Cameron-Ray/IrrigationPiHat/Combined Schematic & PCB/Main Circuit.html

# C:\Users\cdude\University of Cape Town\EEE3088F - General\FinalCircuitSchematic&PCB\Main Circuit.sch

08/06/2021 5:21:09 PM

Eeschema (5.1.10)-1

Component Count:86

Ref | Qnty | Value | Part | Datasheet | Description
C1 | 1 | 0.01µ | Device:C_Small | ~ | Unpolarized capacitor, small symbol
C2 | 1 | 1n | Device:C_Small | ~ | Unpolarized capacitor, small symbol
C3 | 1 | Cpar=100p,Rser=10k | Device:C_Small | ~ | Unpolarized capacitor, small symbol
C4 | 1 | 4.7µ | Device:C_Small | ~ | Unpolarized capacitor, small symbol
C5, C6 | 2 | 0.1µ | Device:C_Small | ~ | Unpolarized capacitor, small symbol
C7 | 1 | 150µ x3, Rser=0.1 | Device:C_Small | ~ | Unpolarized capacitor, small symbol
D1, D4 | 2 | Red LED | Device:LED | ~ | Light emitting diode
D2, D5 | 2 | Orange LED | Device:LED | ~ | Light emitting diode
D3, D6 | 2 | Green LED | Device:LED | ~ | Light emitting diode
IC1 | 1 | LTC3895IFE#TRPBF | LTC3895PartLib:LTC3895IFE#TRPBF | https://www.analog.com/media/en/technical-documentation/data-sheets/3895fa.pdf
J1, J2, J3, J5, J6, J7, J8 | 7 | Conn_01x02_Male | Connector:Conn_01x02_Male | ~ | Generic connector, single row, 01x02, script generated (kicad-library-utils/schlib/autogen/connector/)
J4 | 1 | Raspberry_Pi_2_3 | Connector:Raspberry_Pi_2_3 | https://www.raspberrypi.org/documentation/hardware/raspberrypi/schematics/rpi_SCH_3bplus_1p0_reduced.pdf | expansion header for Raspberry Pi 2 & 3
L1 | 1 | 33µ, Rser=15m | Device:L_Small | ~ | Inductor, small symbol
Q1, Q2, Q3, Q4 | 4 | PN2222A | Transistor_BJT:PN2222A | http://www.fairchildsemi.com/ds/PN/PN2222A.pdf | 1A Ic, 40V Vce, NPN Transistor, General Purpose Transistor, TO-92
Q5 | 1 | Si4482DY | Transistor_FET:BSC082N10LSG | http://www.infineon.com/dgdl/Infineon-BSC082N10LS-DS-v01_07-en.pdf?fileId=db3a3043163797a6011647faad240719 | 100A Id, 100V Vds, OptiMOS N-Channel Power MOSFET, 8.2mOhm Ron, Qg (typ) 78.0nC, PG-TDSON-8
Q6, Q7 | 2 | BSC082N10LSG | Transistor_FET:BSC082N10LSG | http://www.infineon.com/dgdl/Infineon-BSC082N10LS-DS-v01_07-en.pdf?fileId=db3a3043163797a6011647faad240719 | 100A Id, 100V Vds, OptiMOS N-Channel Power MOSFET, 8.2mOhm Ron, Qg (typ) 78.0nC, PG-TDSON-8
R1, R13 | 2 | 10K | Device:R_Small_US | ~ | Resistor, small US symbol
R2, R4, R6, R7, R11, R12, R14, R15, R17, R19, R20, R29, R30, R31 | 14 | 1K | Device:R_Small_US | ~ | Resistor, small US symbol
R3, R16 | 2 | 3636 | Device:R_Small_US | ~ | Resistor, small US symbol
R5, R18 | 2 | 2.5K | Device:R_Small_US | ~ | Resistor, small US symbol
R8, R9, R10, R21, R22, R23 | 6 | 160 | Device:R_Small_US | ~ | Resistor, small US symbol
R24 | 1 | 75k | Device:R_Small_US | ~ | Resistor, small US symbol
R25 | 1 | 1Meg | Device:R_Small_US | ~ | Resistor, small US symbol
R26 | 1 | 18.7k | Device:R_Small_US | ~ | Resistor, small US symbol
R27 | 1 | 30.1k | Device:R_Small_US | ~ | Resistor, small US symbol
R28, R33 | 2 | 511k | Device:R_Small_US | ~ | Resistor, small US symbol
R32 | 1 | 36.5k | Device:R_Small_US | ~ | Resistor, small US symbol
R34 | 1 | 6m | Device:R_Small_US | ~ | Resistor, small US symbol
R35, R36 | 2 | 1k | Device:R_Small_US | ~ | Resistor, small US symbol
RV1, RV2, RV3, RV4, RV5, RV6, RV7, RV8, RV9, RV10 | 10 | R_POT | Device:R_POT | ~ | Potentiometer
U1, U2, U3, U4, U6 | 5 | LMV324 | Amplifier_Operational:LMV324 | http://www.ti.com/lit/ds/symlink/lmv324.pdf | Quad Low-Voltage Rail-to-Rail Output Operational Amplifier, SOIC-14/SSOP-14
U5, U7 | 2 | 74HC86 | 74xx:74HC86 | http://www.ti.com/lit/gpn/sn74HC86 | Quad 2-input XOR
U8, U9 | 2 | Switch | Analog_Switch:DG308AxY | http://pdf.datasheetcatalog.com/datasheets/70/494502_DS.pdf | Quad SPST Analog Switches, normally OFF, 60Ohm Ron, SOIC-16
U10 | 1 | LMV321 | Amplifier_Operational:LMV321 | http://www.ti.com/lit/ds/symlink/lmv324.pdf | Low-Voltage Rail-to-Rail Output Operational Amplifiers, SOT-23-5/SC-70-5
