Cameron-Ray/IrrigationPiHat/Combined Schematic & PCB/PCBScreenshots/2D_Back.jpg

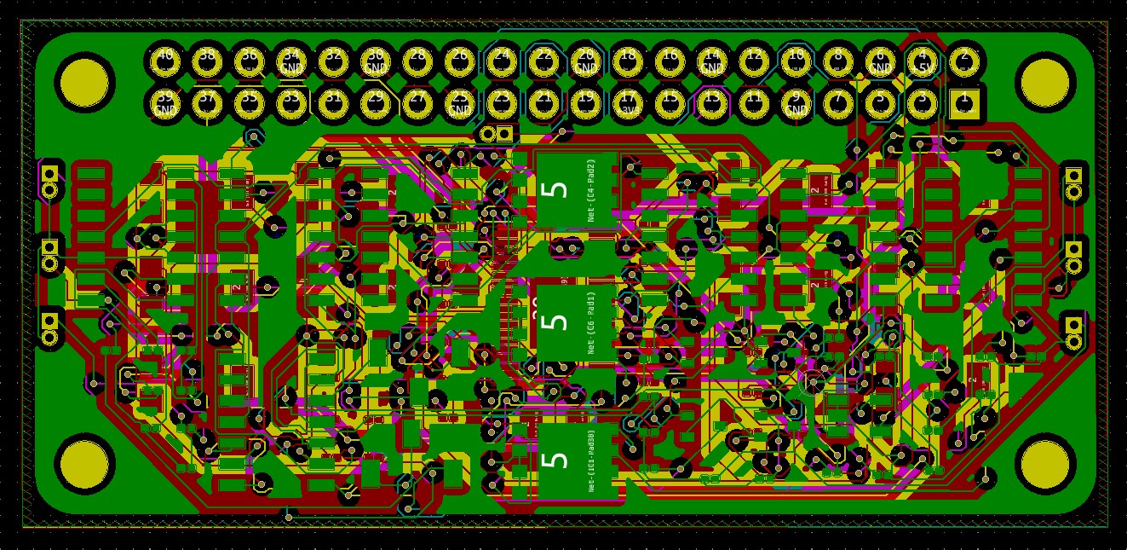
Combined Schematic & PCB/PCBScreenshots/2D_Back.jpg
