Cameron-Ray/IrrigationPiHat/Combined Schematic & PCB/PCBScreenshots/2D_Front.jpg

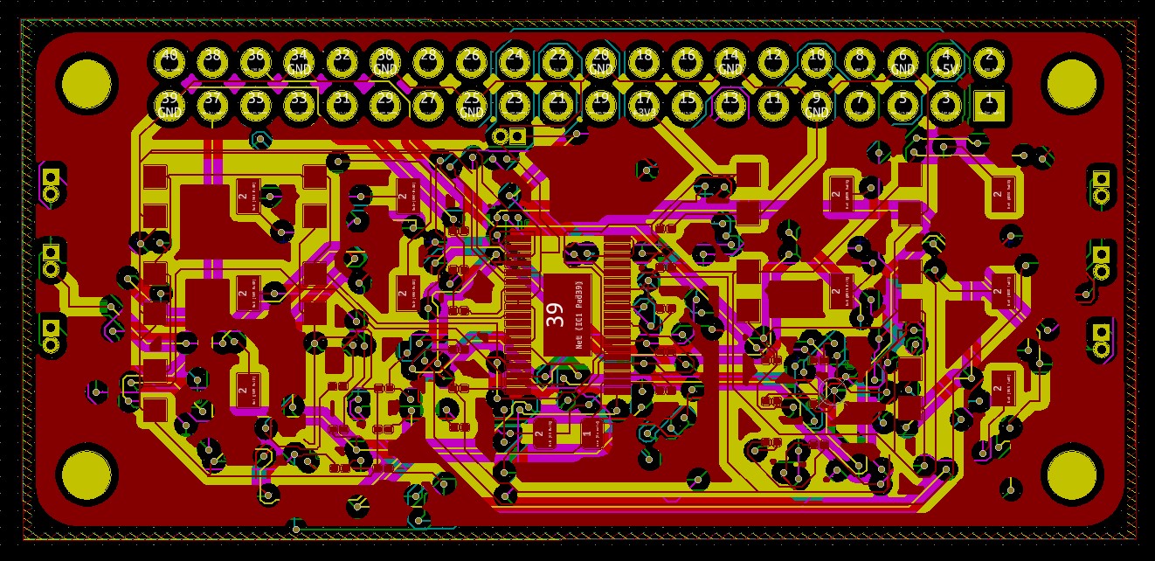
Combined Schematic & PCB/PCBScreenshots/2D_Front.jpg
