Cameron-Ray/IrrigationPiHat/Simulation Files/SimulationPlots/AmpMod_LowerBoundOutput.png

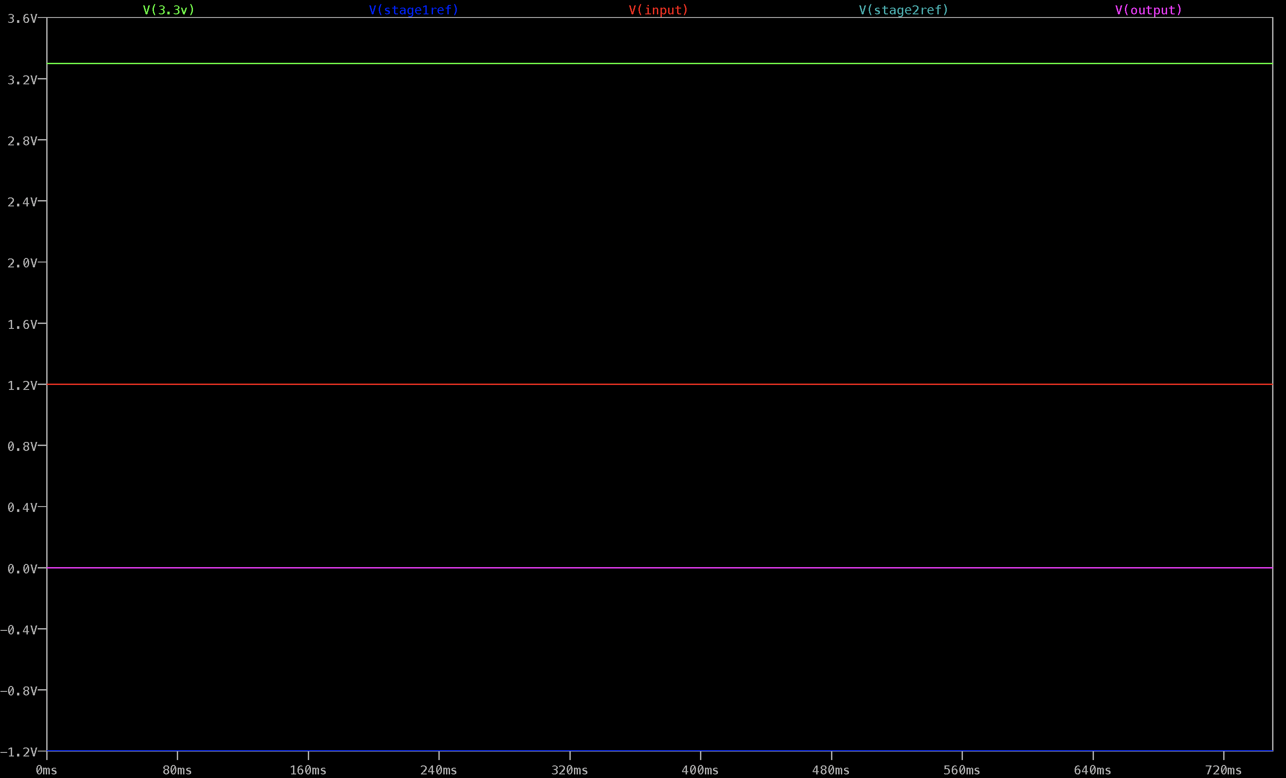
Simulation Files/SimulationPlots/AmpMod_LowerBoundOutput.png
