Cameron-Ray/IrrigationPiHat/Simulation Files/SimulationPlots/AmpMod_SineOutput.png

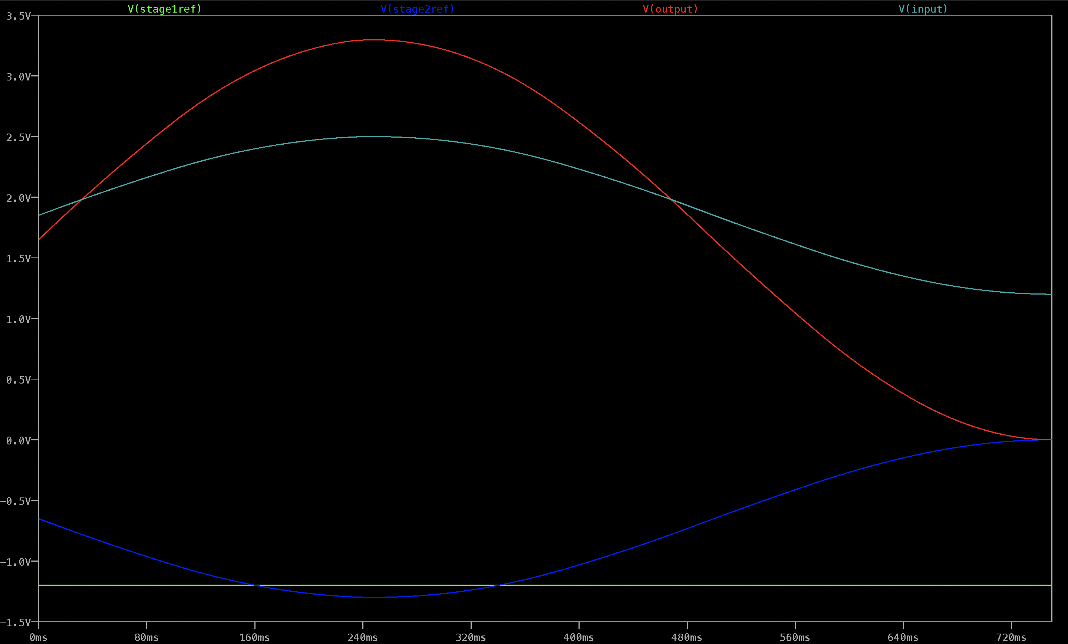
Simulation Files/SimulationPlots/AmpMod_SineOutput.png
