Cameron-Ray/IrrigationPiHat/Simulation Files/SimulationPlots/LEDMod_LEDControl.png

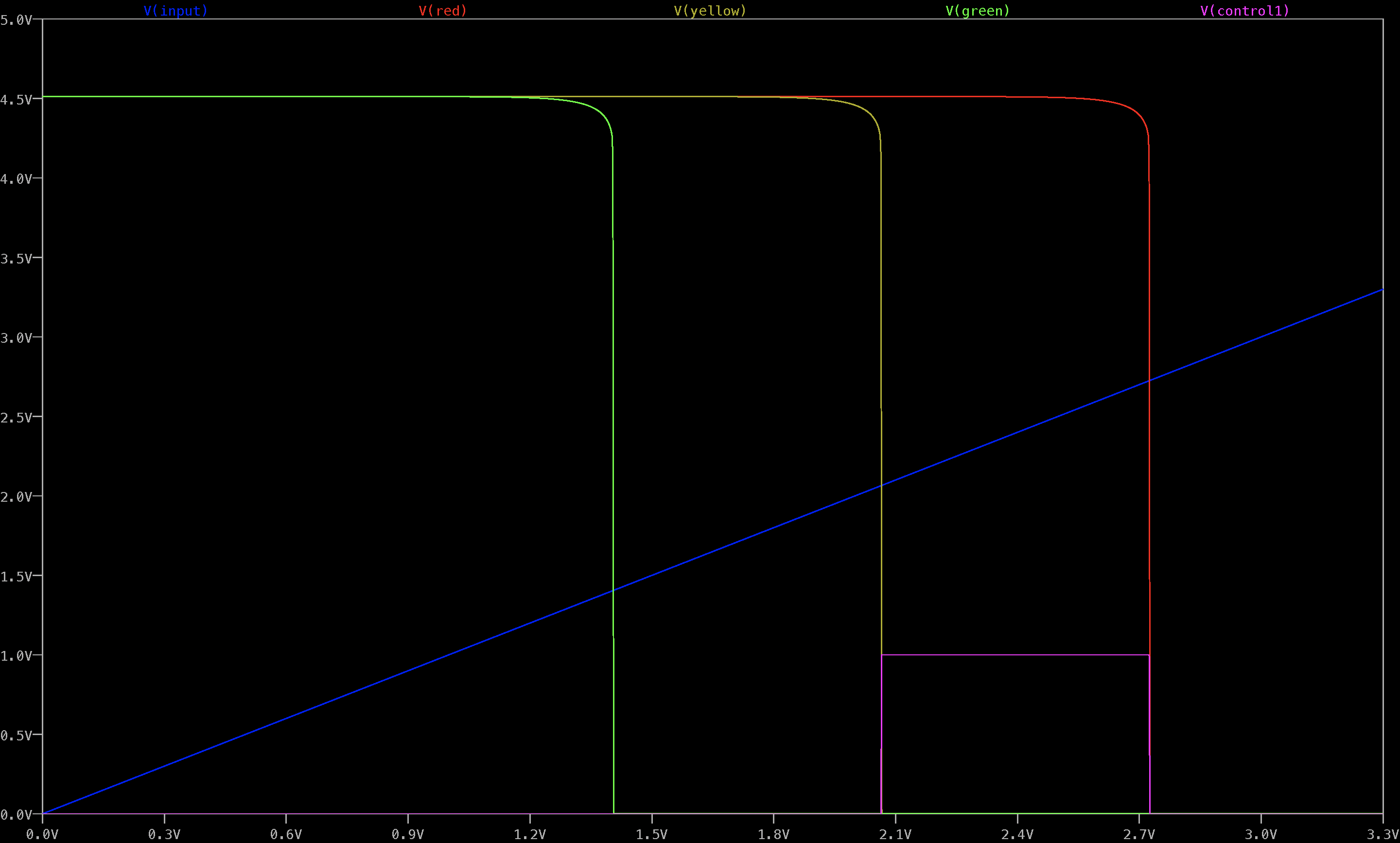
Simulation Files/SimulationPlots/LEDMod_LEDControl.png
