Cameron-Ray/IrrigationPiHat/Simulation Files/SimulationPlots/LEDMod_SolenoidControl.png

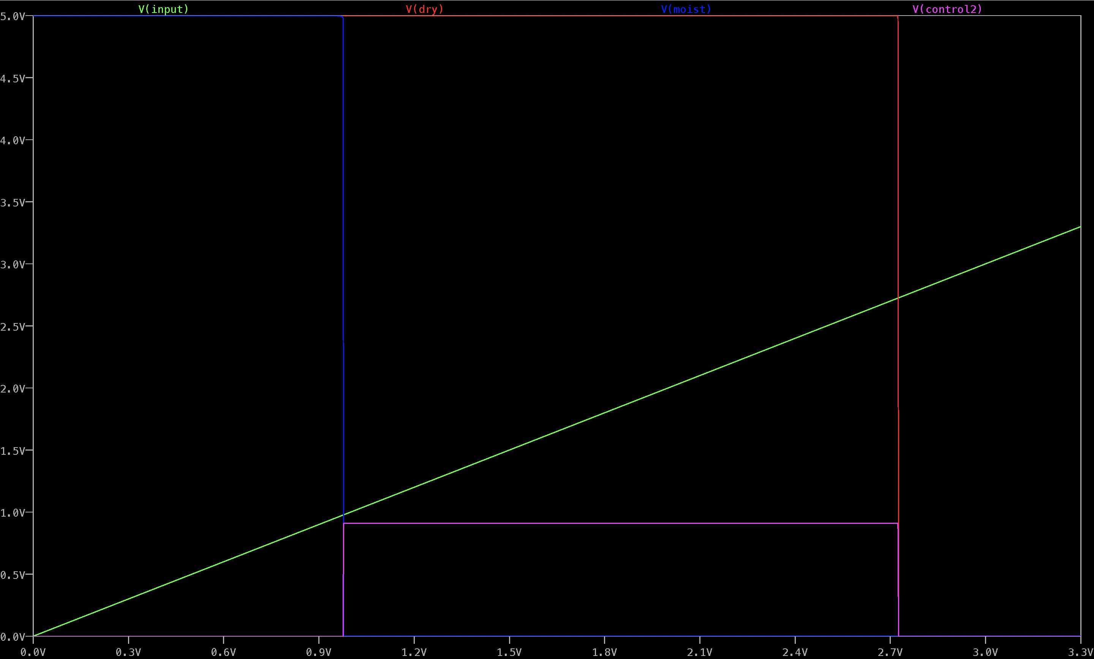
Simulation Files/SimulationPlots/LEDMod_SolenoidControl.png
