Cameron-Ray/IrrigationPiHat/Simulation Files/SimulationPlots/PowerMod_HighEndProtection.jpg

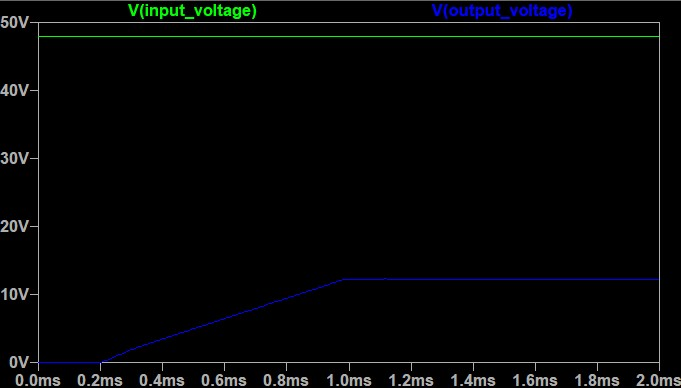
Simulation Files/SimulationPlots/PowerMod_HighEndProtection.jpg
