Cameron-Ray/IrrigationPiHat/Simulation Files/SimulationPlots/PowerMod_LowEndProtection.jpg

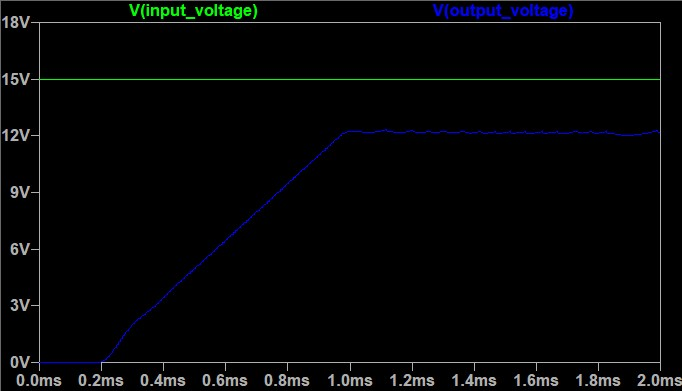
Simulation Files/SimulationPlots/PowerMod_LowEndProtection.jpg
