Cameron-Ray/IrrigationPiHat/Combined Schematic & PCB/KiCad-LTC3895-PCBFootprint&Symbol/LTC3895IFE#TRPBF.stp

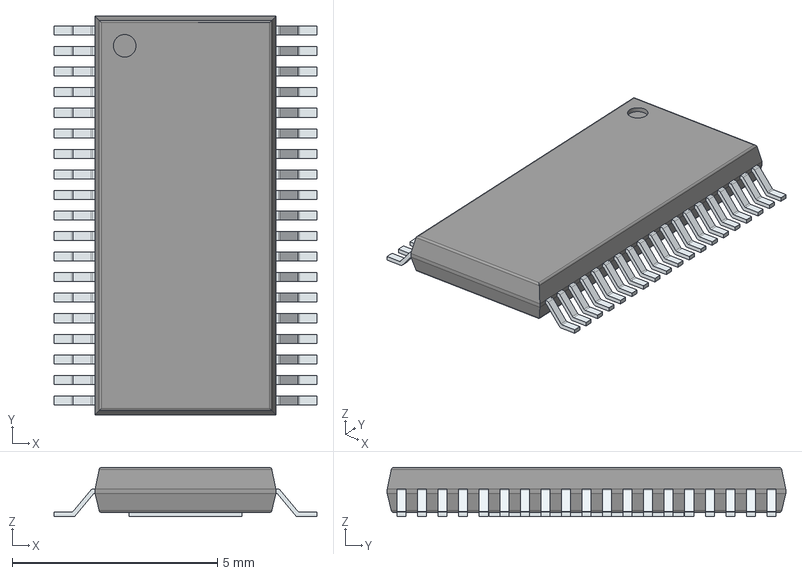
[picture p12: CAD file, 2021-06-03]
Combined Schematic & PCB/KiCad-LTC3895-PCBFootprint&Symbol/LTC3895IFE#TRPBF.stp
6.40 x 9.70 x 1.20 mm
PinsArrayLR
ThermalPad
