Cameron-Ray/IrrigationPiHat/Combined Schematic & PCB/KiCad-JS102011JCQN-PCBFootprint&Symbol/JS102011JCQN.stp

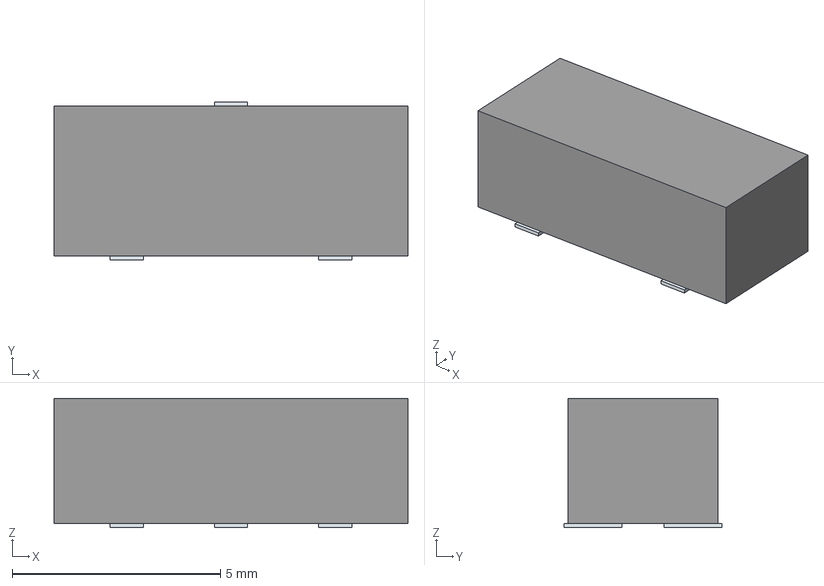
[picture p13: CAD file, 2021-06-09]
Combined Schematic & PCB/KiCad-JS102011JCQN-PCBFootprint&Symbol/JS102011JCQN.stp
8.50 x 3.80 x 3.10 mm
Pins
