Cameron-Ray/IrrigationPiHat/(list of files, cad)

Other CAD files:
Combined Schematic & PCB/KiCad-JS102011JCQN-PCBFootprint&Symbol/JS102011JCQN.stl
Combined Schematic & PCB/KiCad-LTC3895-PCBFootprint&Symbol/LTC3895IFE#TRPBF.stl
