Cameron-Ray/IrrigationPiHat/Combined Schematic & PCB/Main Circuit.pdf

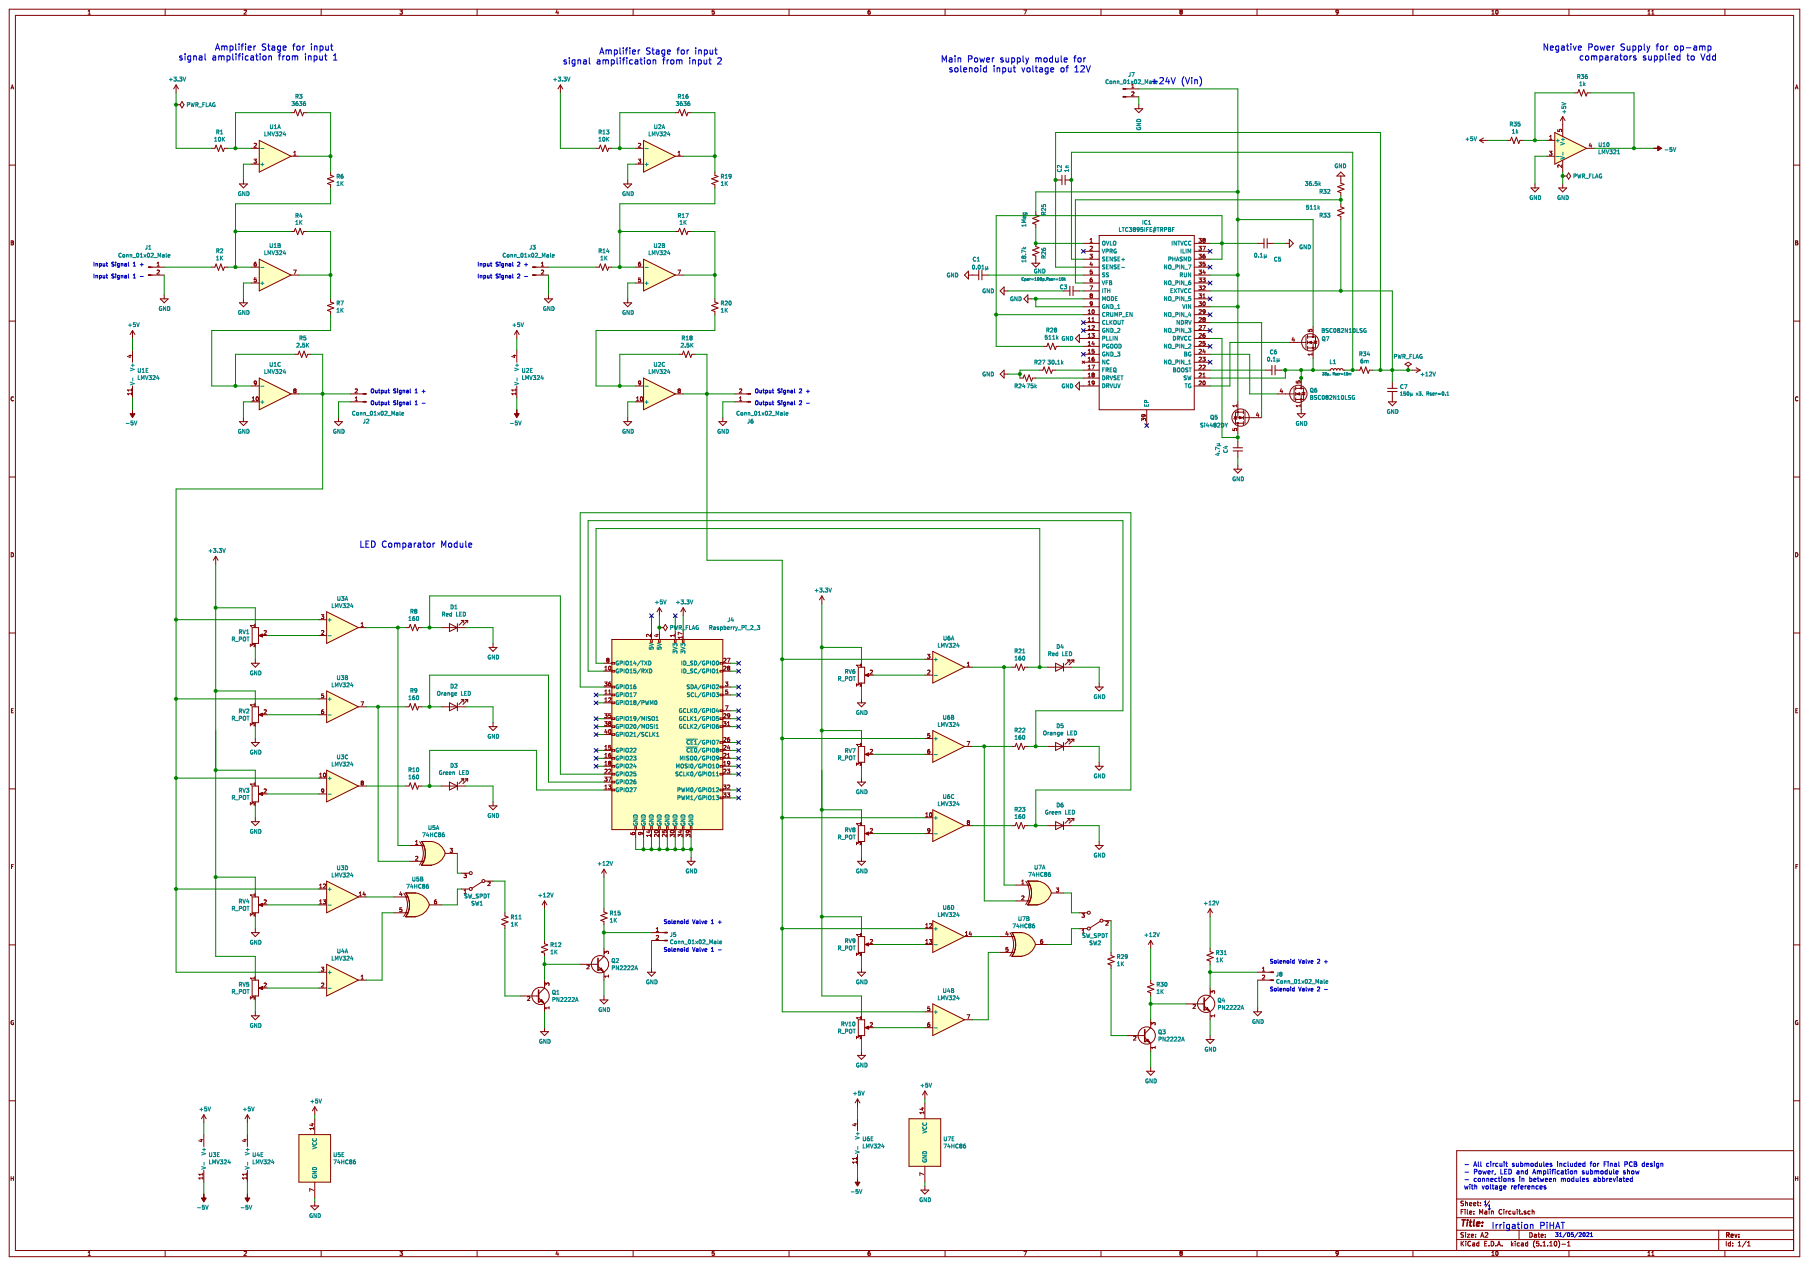
[picture p14: page 1]
