Cameron-Ray/IrrigationPiHat/Individual Module Schematics/AmplifierSubmoduleV2.0.pdf

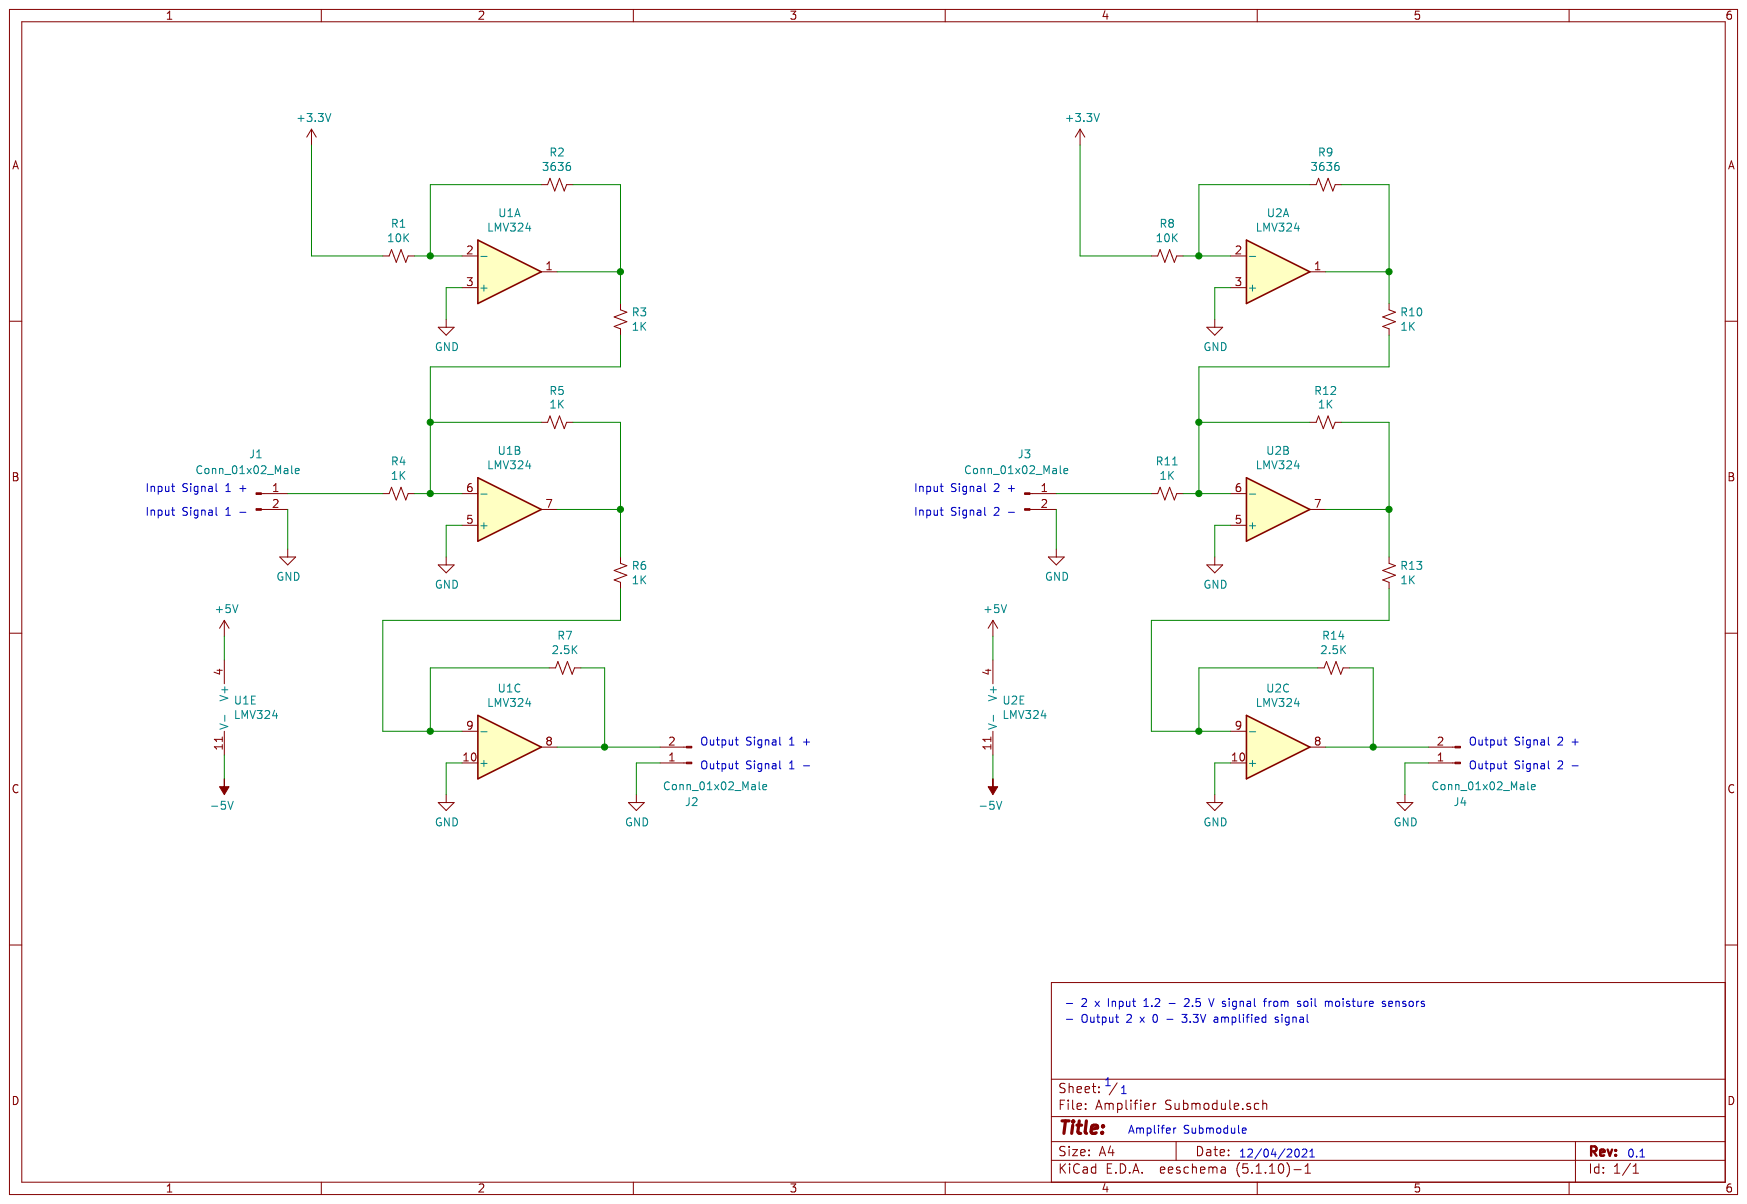
[picture p15: page 1]
