Cameron-Ray/IrrigationPiHat/Individual Module Schematics/LedSubmoduleV2.0.pdf

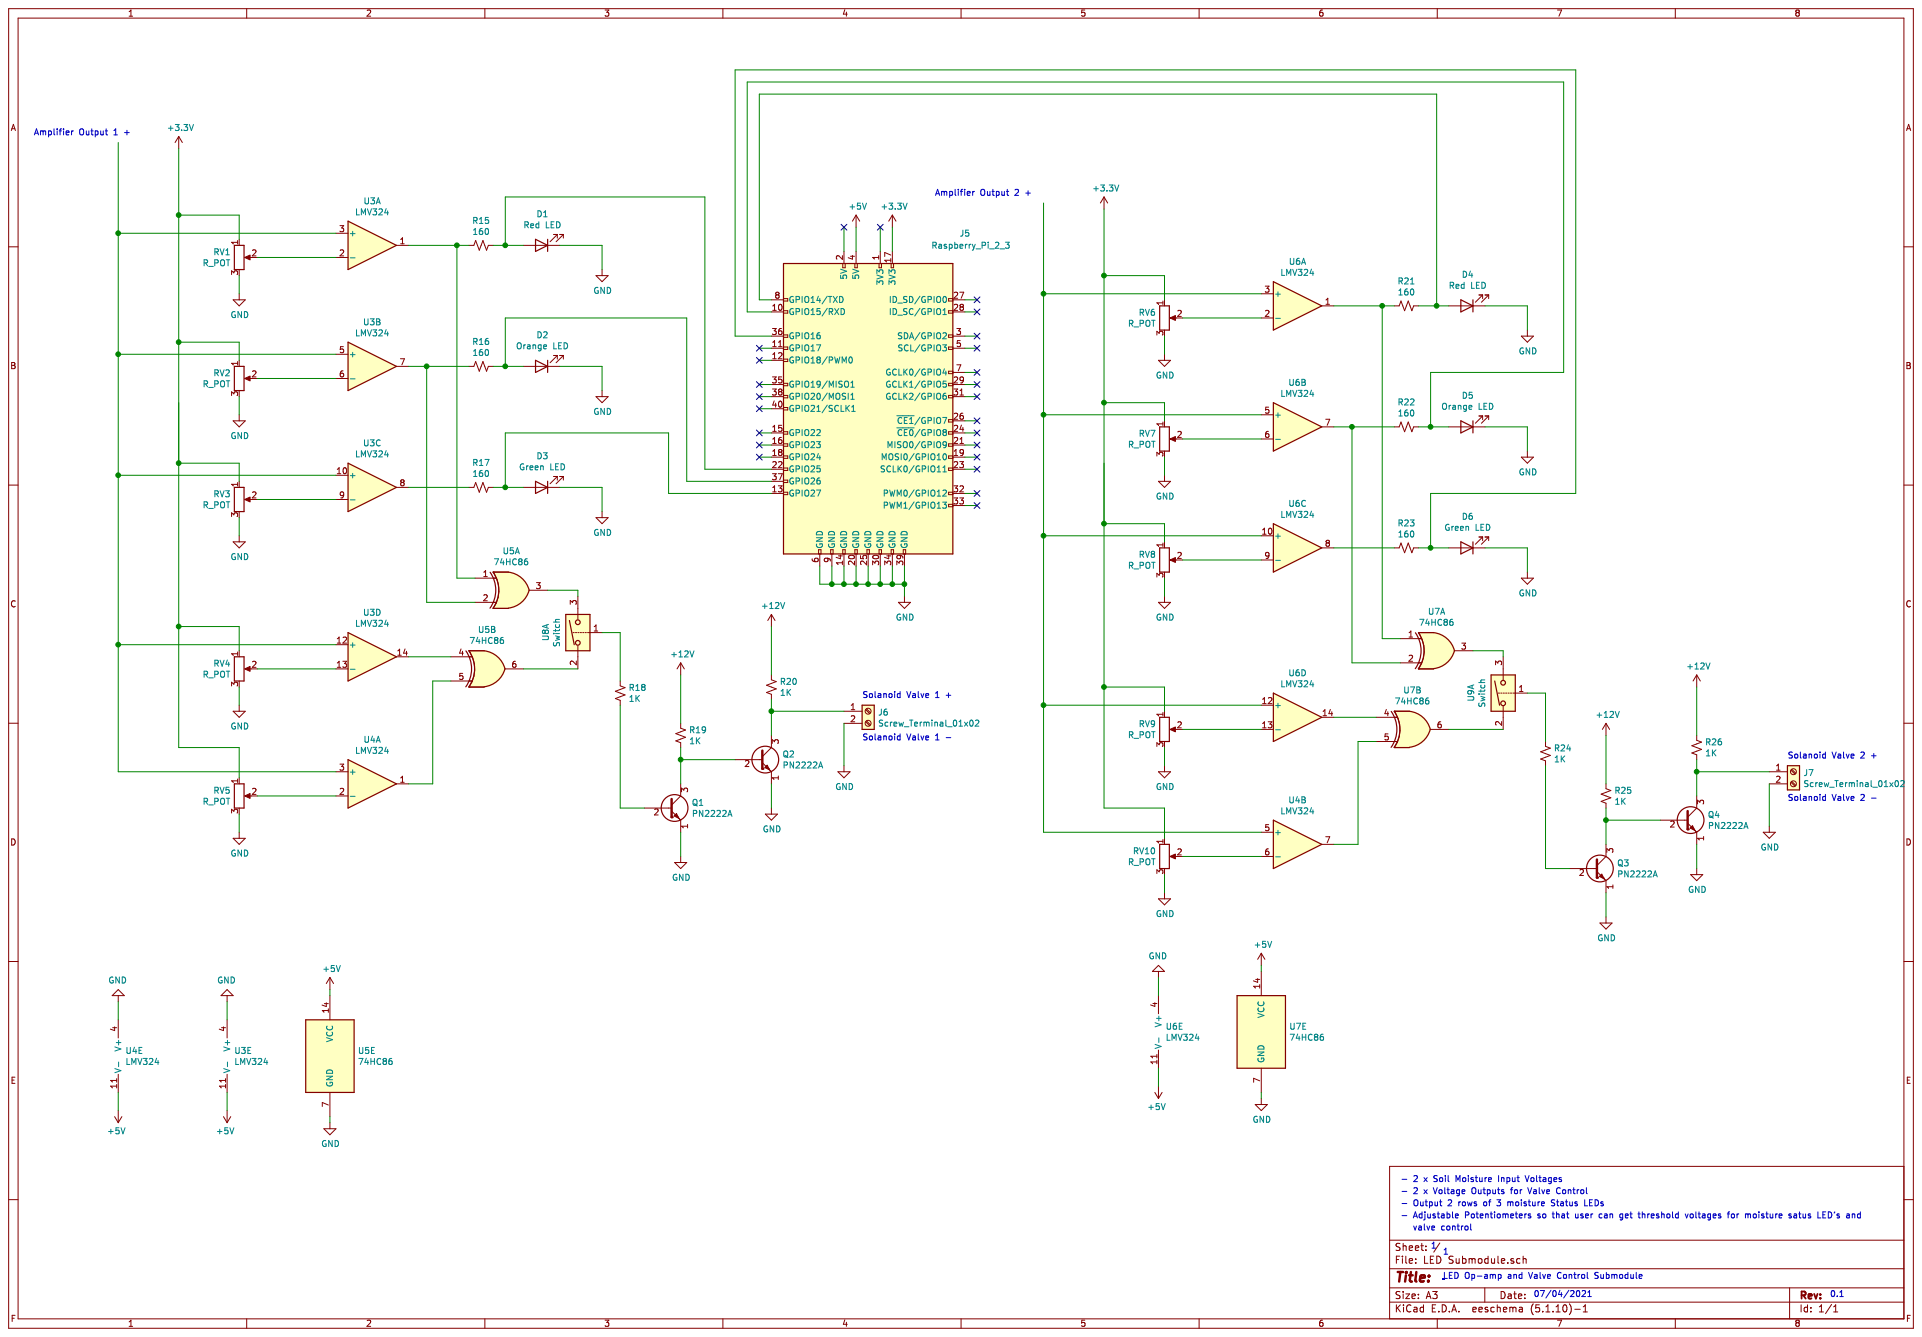
[picture p16: page 1]
