Cameron-Ray/IrrigationPiHat/Individual Module Schematics/PowerSubmoduleV2.0.pdf

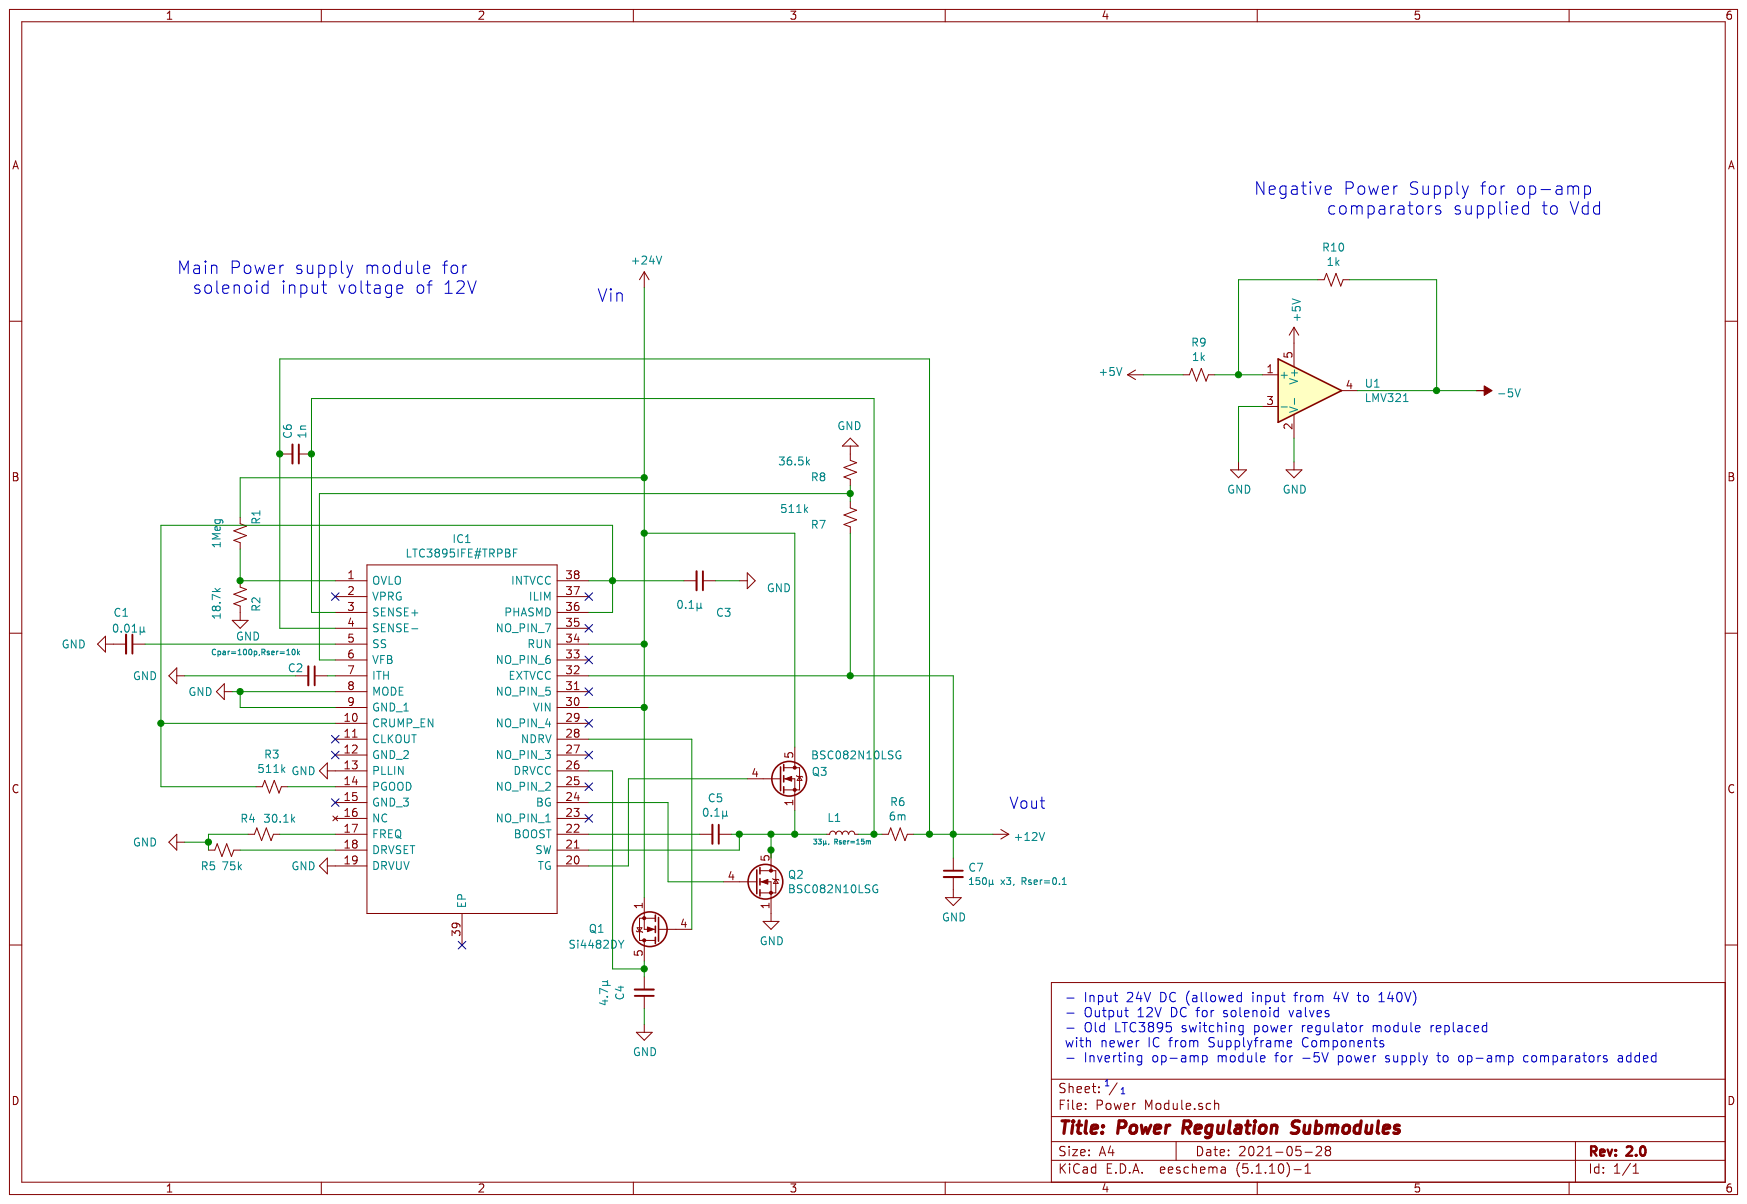
[picture p17: page 1]
