Cameron-Ray/IrrigationPiHat/Simulation Files/PowerSim/Power Submodule.asc

C1: cap; 150µ; x3; Rser=0.1
C2: cap; 0.1µ
C3: cap; 0.1µ
C4: cap; 4.7n; Rser=10K; Cpar=100p
C5: cap; 0.01µ
C6: cap; 1n
C7: cap; 4.7µ
L1: ind; 33µ; Rser=15m
Q1: nmos; BSC082N10LS
Q2: nmos; BSC082N10LS
Q3: nmos; Si4482DY
R1: res; 511K
R2: res; 36.5K
R3: res; 6m
R4: res; 30.1K
R5: res; 511K
R6: res; 1Meg
R7: res; 18.7K
R8: res; 75K
R_Simulated_Load: res; 10
U1: LTC3895
V1: voltage; 48
Named nets: 0, Output_Voltage, Input_Voltage
.tran 2m
