Cameron-Ray/IrrigationPiHat/Simulation Files/AmplifierSim/Amplifier Submodule.asc

R1: res; 10K
R2: res; 3636
R3: res; 1K
R4: res; 1K
R5: res; 1K
R6: res; 1K
R7: res; 2538
U1: UniversalOpamp2
U2: UniversalOpamp2
U3: UniversalOpamp2
V1: voltage; 5
V2: voltage; 3.3
V3: voltage; 5
V4: voltage; SINE(1.85 0.65 1)
Named nets: 0, 5V, 3.3V, -5V, Stage1Ref, Stage2Ref, Input, Output
.tran 0.75
.lib opamp.sub
