Cameron-Ray/IrrigationPiHat/Combined Schematic & PCB/Main Circuit.kicad_pcb

## KiCad design Combined Schematic & PCB/Main Circuit.kicad_pcb (2021-06-09)

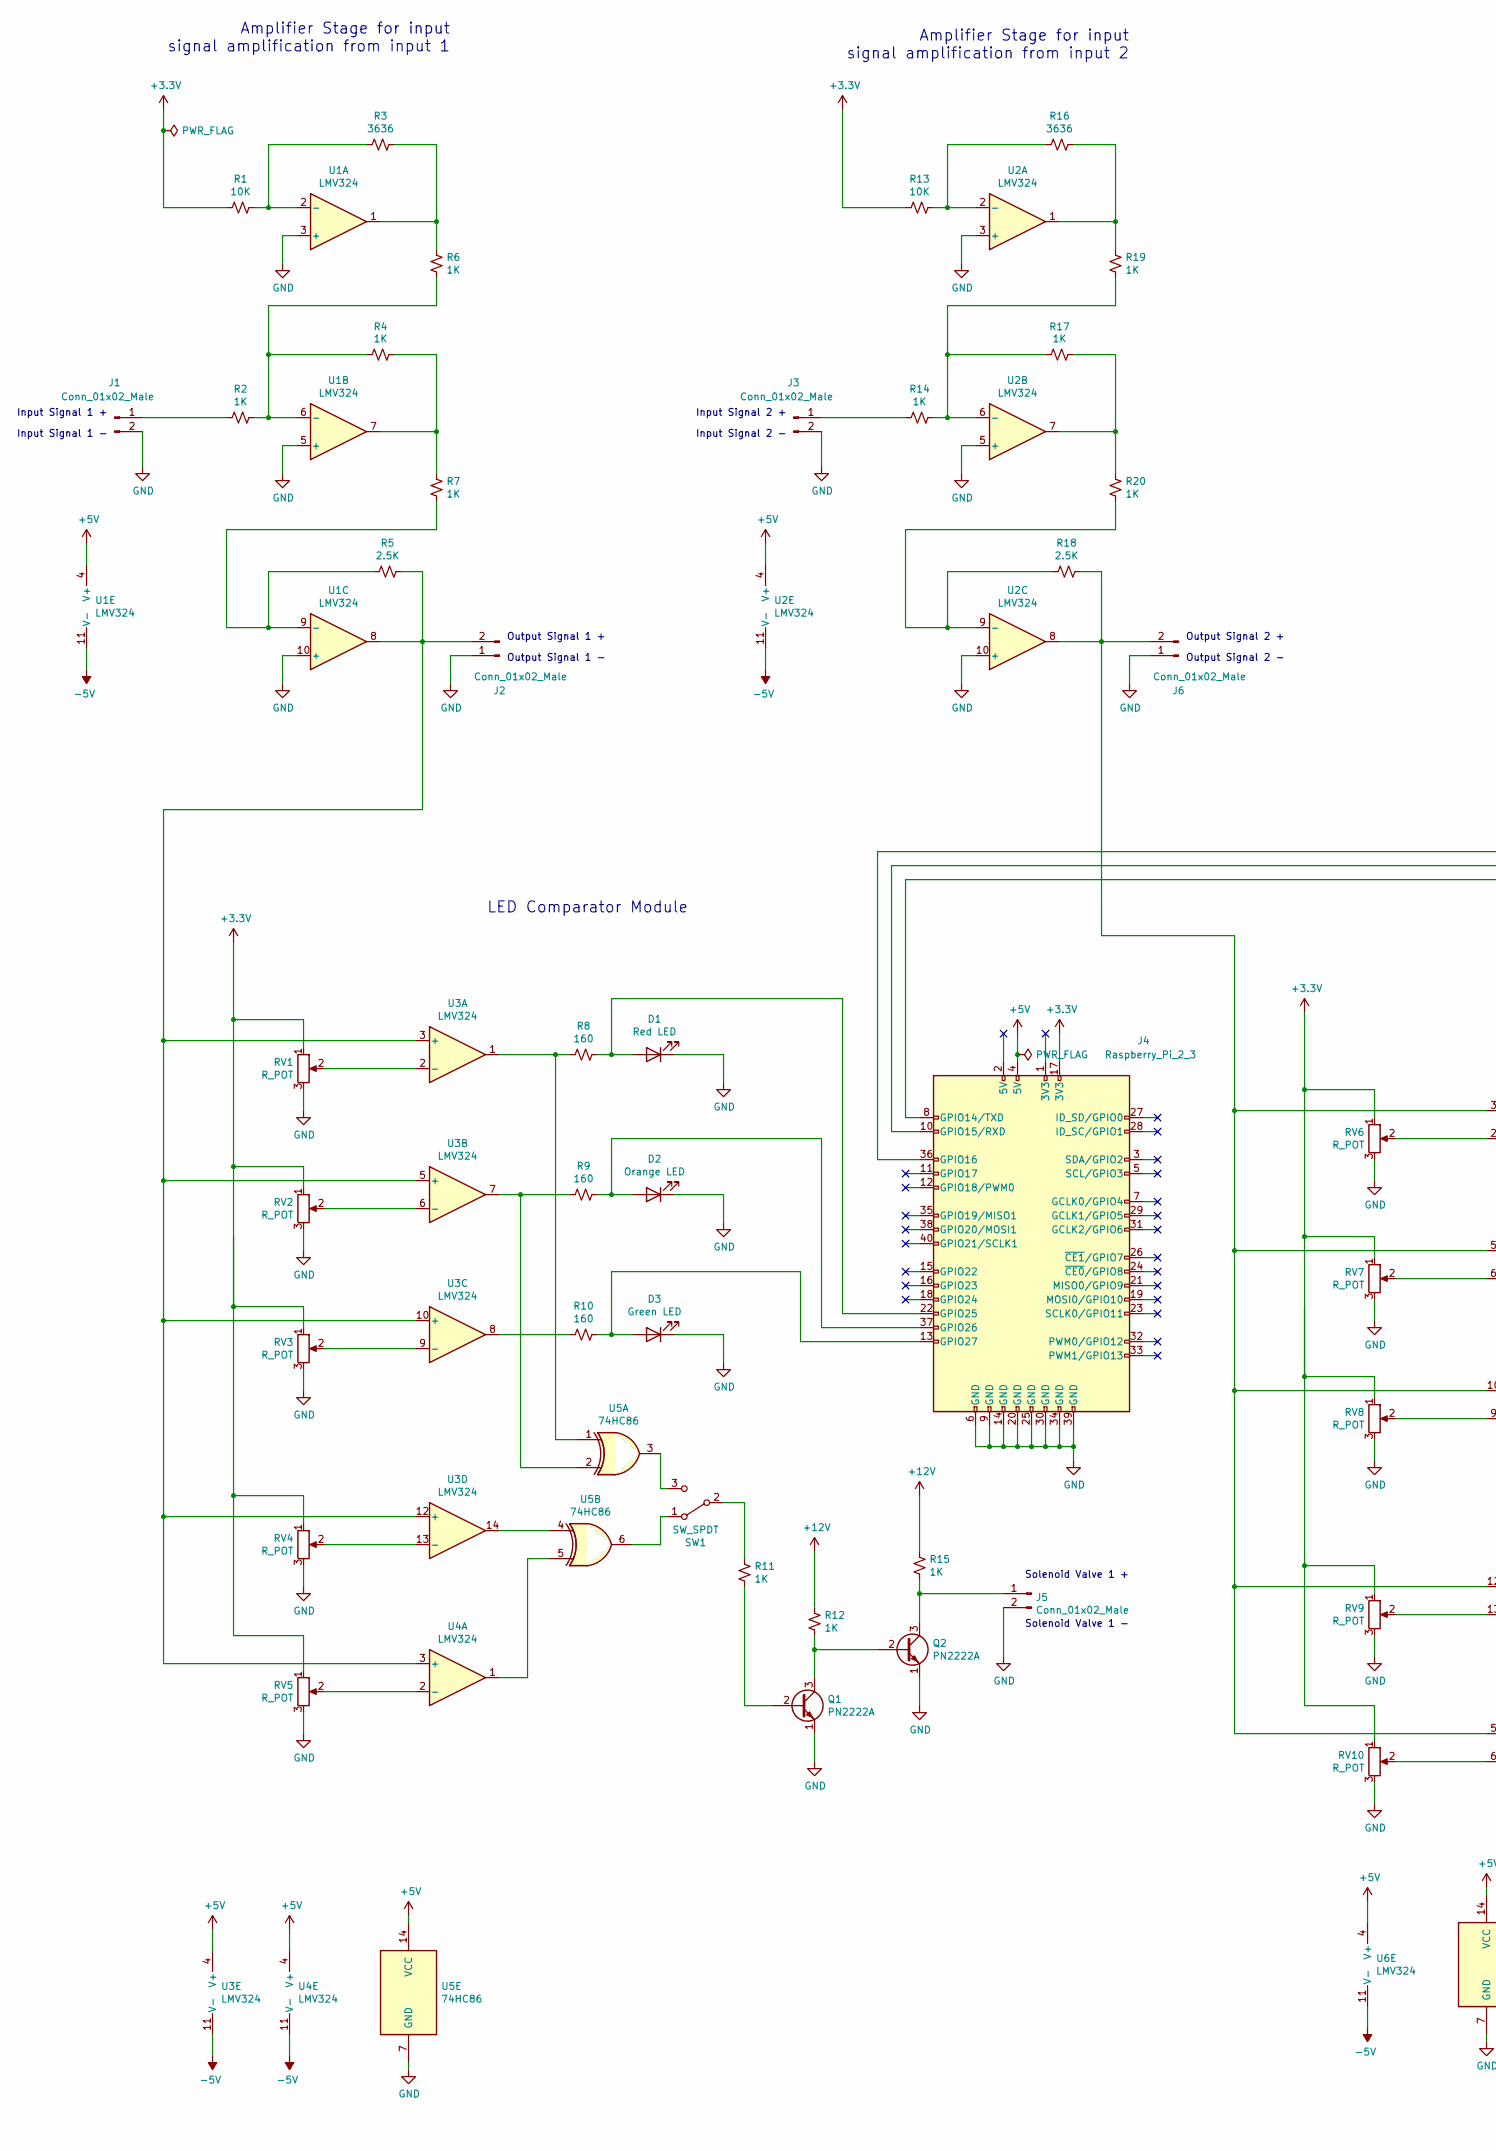
[picture p18: schematic Main Circuit.sch, part in row 1, column 1]

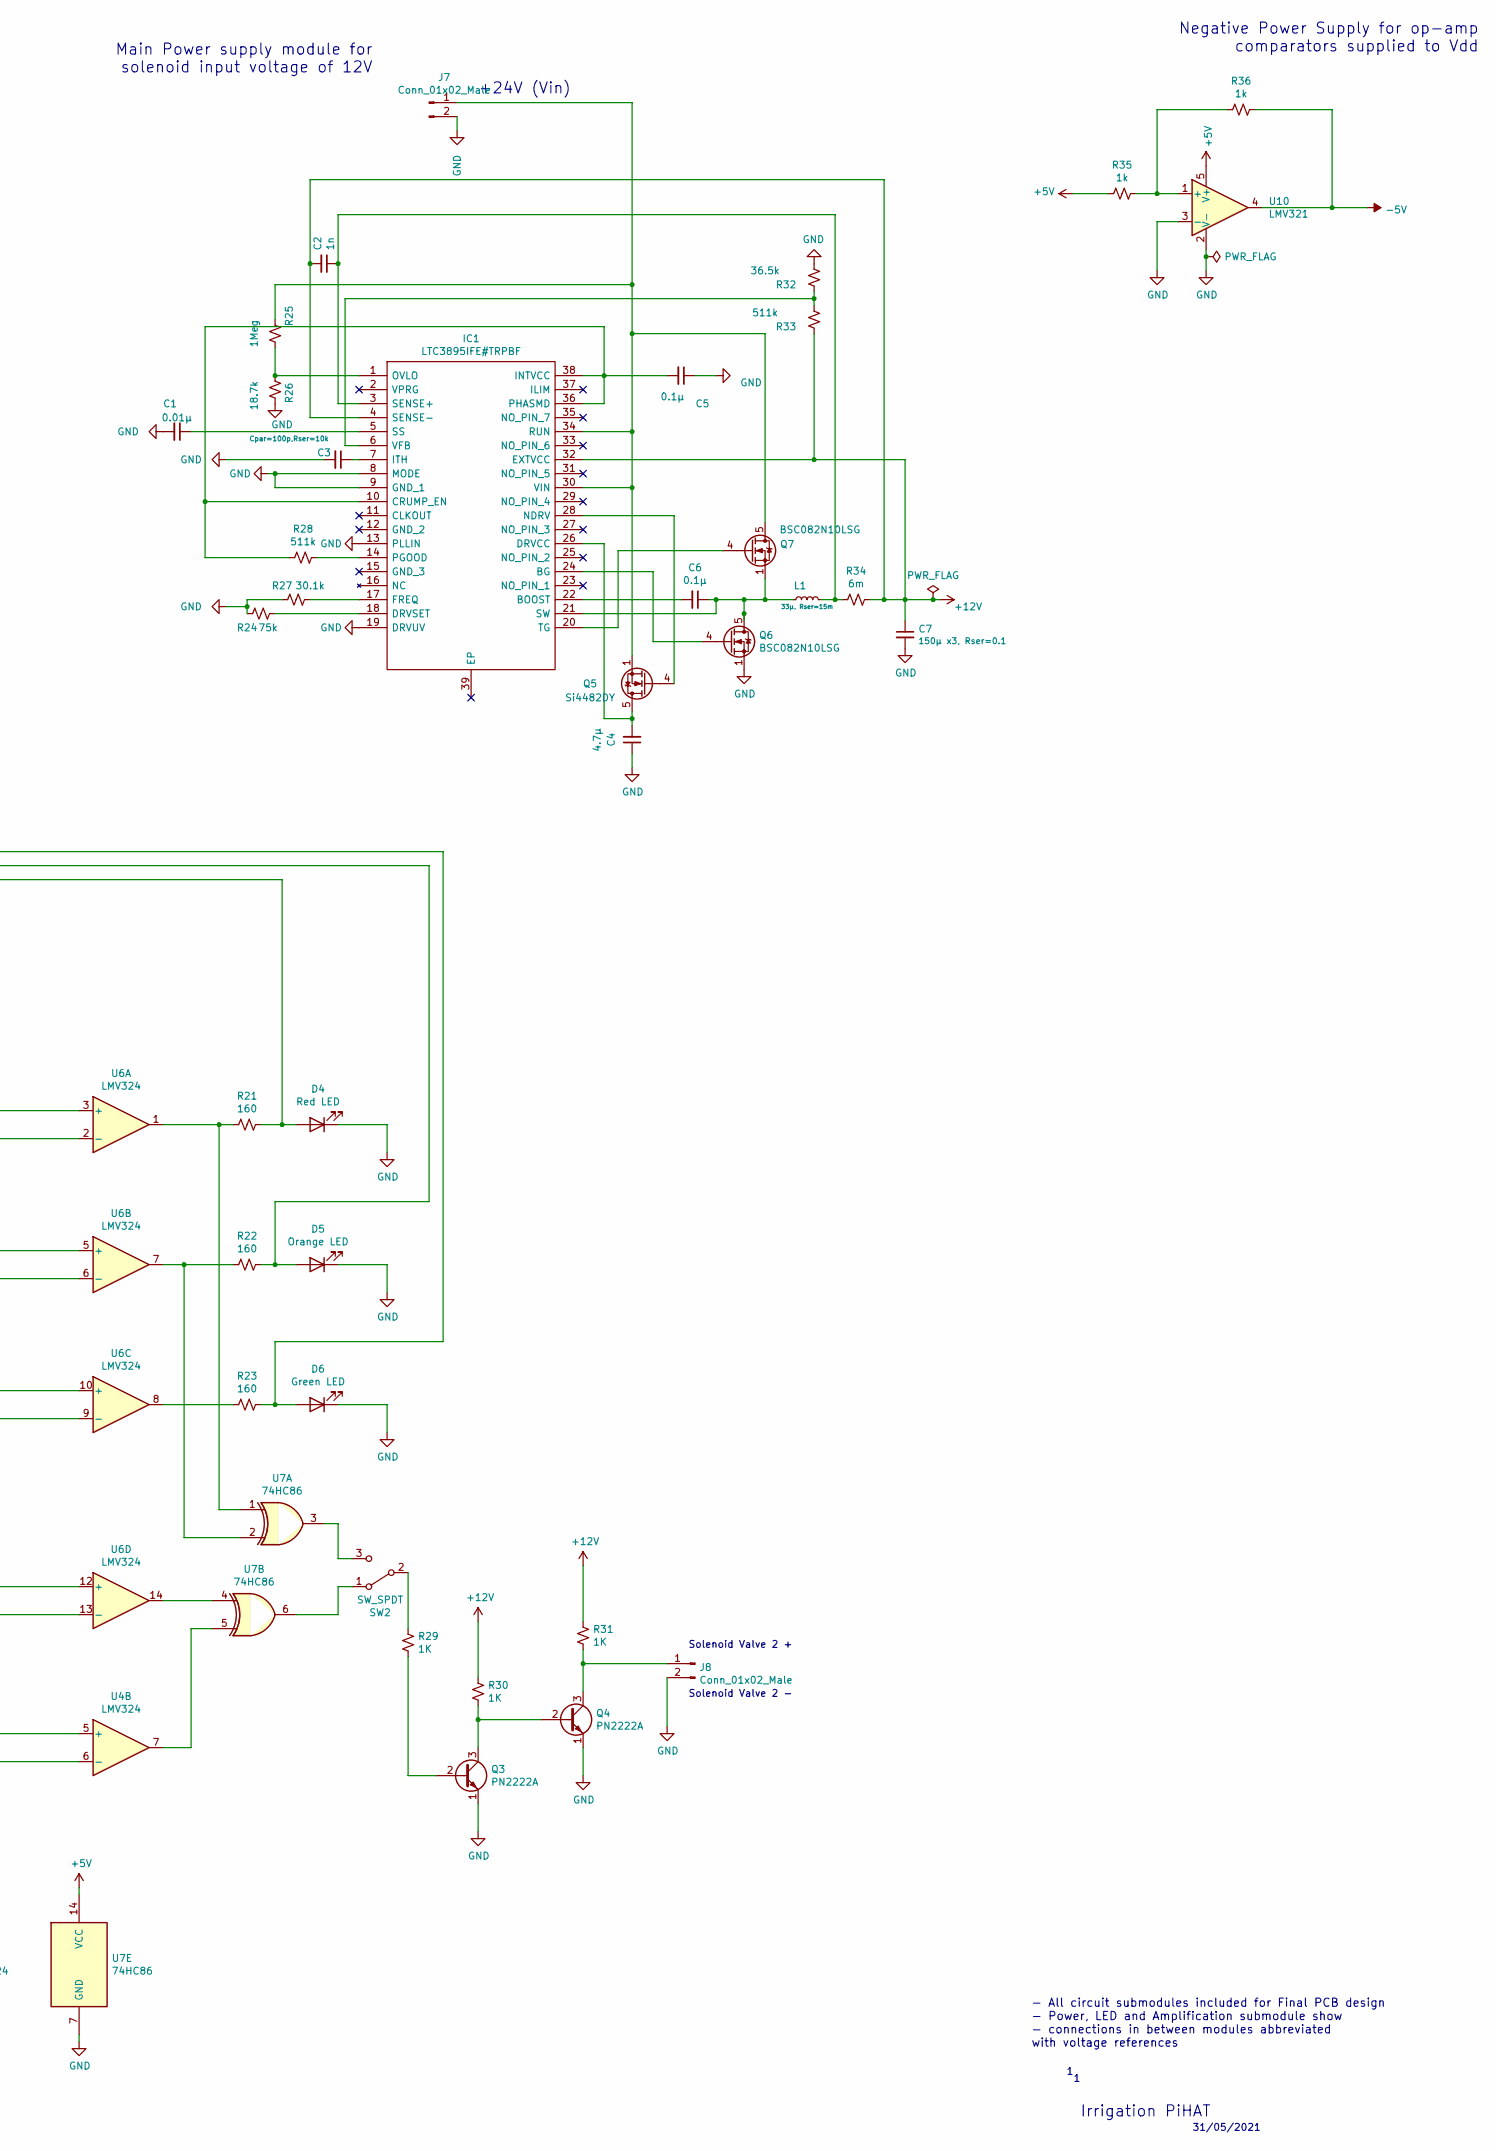
[picture p19: schematic Main Circuit.sch, part in row 1, column 2]

Parts:
C1: 0.01µ; C_0201_0603Metric
C2: 1n; C_0201_0603Metric
C3: Cpar=100p,Rser=10k; C_0201_0603Metric
C4: 4.7µ; C_0201_0603Metric
C5, C6: 0.1µ; C_0201_0603Metric
C7: 150µ x3, Rser=0.1; C_0201_0603Metric
D1, D4: Red LED; LED_0201_0603Metric
D2, D5: Orange LED; LED_0201_0603Metric
D3, D6: Green LED; LED_0201_0603Metric
IC1: LTC3895IFE#TRPBF; SOP50P640X120-39N; Manufacturer_Part_Number LTC3895IFE#TRPBF; Mouser Part Number 584-LTC3895IFE#TRPBF
J1, J2, J3, J5, J6, J7, J8: Conn_01x02_Male; PinHeader_1x02_P1.00mm_Vertical
J4: Raspberry_Pi_2_3; Raspberry_Pi_Zero_Socketed_THT_FaceDown_MountingHoles
L1: 33µ, Rser=15m; L_1206_3216Metric
Q1, Q2, Q3, Q4: PN2222A; SOT-323_SC-70
Q5: Si4482DY; TDSON-8-1
Q6, Q7: BSC082N10LSG; TDSON-8-1
R1, R13: 10K; R_0201_0603Metric
R2, R4, R6, R7, R11, R12, R14, R15, R17, R19, R20, R29, R30, R31: 1K; R_0201_0603Metric
R3, R16: 3636; R_0201_0603Metric
R5, R18: 2.5K; R_0201_0603Metric
R8, R9, R10, R21, R22, R23: 160; R_0201_0603Metric
R24: 75k; R_0201_0603Metric
R25: 1Meg; R_0201_0603Metric
R26: 18.7k; R_0201_0603Metric
R27: 30.1k; R_0201_0603Metric
R28, R33: 511k; R_0201_0603Metric
R32: 36.5k; R_0201_0603Metric
R34: 6m; R_0201_0603Metric
R35, R36: 1k; R_0201_0603Metric
RV1, RV2, RV3, RV4, RV5, RV6, RV7, RV8, RV9, RV10: R_POT; Potentiometer_Bourns_3314G_Vertical
SW1, SW2: SW_SPDT; JS102011JCQN
U1, U2, U3, U4, U6: LMV324; SOIC-14_3.9x8.7mm_P1.27mm
U5, U7: 74HC86; SOIC-14_3.9x8.7mm_P1.27mm
U10: LMV321; TSOT-23-5

Connections:
+3V3: J4.17 (3V3), R1.2, R13.2, RV1.1, RV2.1, RV3.1, RV4.1, RV5.1, RV6.1, RV7.1, RV8.1, RV9.1, RV10.1
+5V: J4.4 (5V), R35.2, U1.4 (V+), U2.4 (V+), U3.4 (V+), U4.4 (V+), U5.14 (VCC), U6.4 (V+), U7.14 (VCC), U10.5 (V+)
+12V: C2.2, C7.1, IC1.4 (SENSE-), IC1.32 (EXTVCC), R12.1, R15.1, R30.1, R31.1, R33.1, R34.1
-5V: R36.1, U1.11 (V-), U2.11 (V-), U3.11 (V-), U4.11 (V-), U6.11 (V-), U10.4
GND: C1.2, C3.2, C4.1, C5.1, C7.2, D1.1 (K), D2.1 (K), D3.1 (K), D4.1 (K), D5.1 (K), D6.1 (K), IC1.8 (MODE), IC1.9 (GND_1), IC1.13 (PLLIN), IC1.19 (DRVUV), J1.2, J2.1, J3.2, J4.6 (GND), J4.9 (GND), J4.14 (GND), J4.20 (GND), J4.25 (GND), J4.30 (GND), J4.34 (GND), J4.39 (GND), J5.2, J6.1, J7.2, J8.2, Q1.1 (E), Q2.1 (E), Q3.1 (E), Q4.1 (E), Q6.1 (S), Q6.2 (S), Q6.3 (S), R24.2, R26.2, R27.2, R32.2, RV1.3, RV2.3, RV3.3, RV4.3, RV5.3, RV6.3, RV7.3, RV8.3, RV9.3, RV10.3, U1.3 (+), U1.5 (+), U1.10 (+), U2.3 (+), U2.5 (+), U2.10 (+), U5.7 (GND), U7.7 (GND), U10.2 (V-), U10.3 (-)
unnamed: C1.1, IC1.5 (SS)
unnamed: C2.1, IC1.3 (SENSE+), L1.2, R34.2
unnamed: C3.1, IC1.7 (ITH)
unnamed: C4.2, IC1.26 (DRVCC), Q5.5 (D)
unnamed: C5.2, IC1.10 (CRUMP_EN), IC1.36 (PHASMD), IC1.38 (INTVCC), R28.2
unnamed: C6.1, IC1.21 (SW), L1.1, Q6.5 (D), Q7.1 (S), Q7.2 (S), Q7.3 (S)
unnamed: C6.2, IC1.22 (BOOST)
unnamed: D1.2 (A), J4.22 (GPIO25), R8.1
unnamed: D2.2 (A), J4.37 (GPIO26), R9.1
unnamed: D3.2 (A), J4.13 (GPIO27), R10.1
unnamed: D4.2 (A), J4.8 (GPIO14/TXD), R21.1
unnamed: D5.2 (A), J4.10 (GPIO15/RXD), R22.1
unnamed: D6.2 (A), J4.36 (GPIO16), R23.1
unnamed: IC1.1 (OVLO), R25.2, R26.1
unnamed: IC1.6 (VFB), R32.1, R33.2
unnamed: IC1.14 (PGOOD), R28.1
unnamed: IC1.17 (FREQ), R27.1
unnamed: IC1.18 (DRVSET), R24.1
unnamed: IC1.20 (TG), Q7.4 (G)
unnamed: IC1.24 (BG), Q6.4 (G)
unnamed: IC1.28 (NDRV), Q5.4 (G)
unnamed: IC1.30 (VIN), IC1.34 (RUN), J7.1, Q5.1 (S), Q5.2 (S), Q5.3 (S), Q7.5 (D), R25.1
unnamed: J1.1, R2.2
unnamed: J2.2, R5.1, U1.8, U3.3 (+), U3.5 (+), U3.10 (+), U3.12 (+), U4.3 (+)
unnamed: J3.1, R14.2
unnamed: J5.1, Q2.3 (C), R15.2
unnamed: J6.2, R18.1, U2.8, U4.5 (+), U6.3 (+), U6.5 (+), U6.10 (+), U6.12 (+)
unnamed: J8.1, Q4.3 (C), R31.2
unnamed: Q1.2 (B), R11.2
unnamed: Q1.3 (C), Q2.2 (B), R12.2
unnamed: Q3.2 (B), R29.2
unnamed: Q3.3 (C), Q4.2 (B), R30.2
unnamed: R1.1, R3.2, U1.2 (-)
unnamed: R2.1, R4.2, R6.2, U1.6 (-)
unnamed: R3.1, R6.1, U1.1
unnamed: R4.1, R7.1, U1.7
unnamed: R5.2, R7.2, U1.9 (-)
unnamed: R8.2, U3.1, U5.1
unnamed: R9.2, U3.7, U5.2
unnamed: R10.2, U3.8
unnamed: R11.1, SW1.2 (B)
unnamed: R13.1, R16.2, U2.2 (-)
unnamed: R14.1, R17.2, R19.2, U2.6 (-)
unnamed: R16.1, R19.1, U2.1
unnamed: R17.1, R20.1, U2.7
unnamed: R18.2, R20.2, U2.9 (-)
unnamed: R21.2, U6.1, U7.1
unnamed: R22.2, U6.7, U7.2
unnamed: R23.2, U6.8
unnamed: R29.1, SW2.2 (B)
unnamed: R35.1, R36.2, U10.1 (+)
unnamed: RV1.2, U3.2 (-)
unnamed: RV2.2, U3.6 (-)
unnamed: RV3.2, U3.9 (-)
unnamed: RV4.2, U3.13 (-)
unnamed: RV5.2, U4.2 (-)
unnamed: RV6.2, U6.2 (-)
unnamed: RV7.2, U6.6 (-)
unnamed: RV8.2, U6.9 (-)
unnamed: RV9.2, U6.13 (-)
unnamed: RV10.2, U4.6 (-)
unnamed: SW1.1 (A), U5.6
unnamed: SW1.3 (C), U5.3
unnamed: SW2.1 (A), U7.6
unnamed: SW2.3 (C), U7.3
unnamed: U3.14, U5.4
unnamed: U4.1, U5.5
unnamed: U4.7, U7.5
unnamed: U6.14, U7.4

Notes on the sheet:
Input Signal 1 +
Input Signal 1 -
Output Signal 1 +
Output Signal 1 -
Input Signal 2 +
Input Signal 2 -
Output Signal 2 +
Output Signal 2 -
Solenoid Valve 1 +
Solenoid Valve 1 -
Solenoid Valve 2 +
Solenoid Valve 2 -
+24V (Vin)
- All circuit submodules included for Final PCB design - Power, LED and Amplification submodule show - connections in between modules abbreviated with voltage references
Negative Power Supply for op-amp comparators supplied to Vdd
Main Power supply module for solenoid input voltage of 12V
Irrigation PiHAT
31/05/2021
Amplifier Stage for input signal amplification from input 2
Amplifier Stage for input signal amplification from input 1
LED Comparator Module

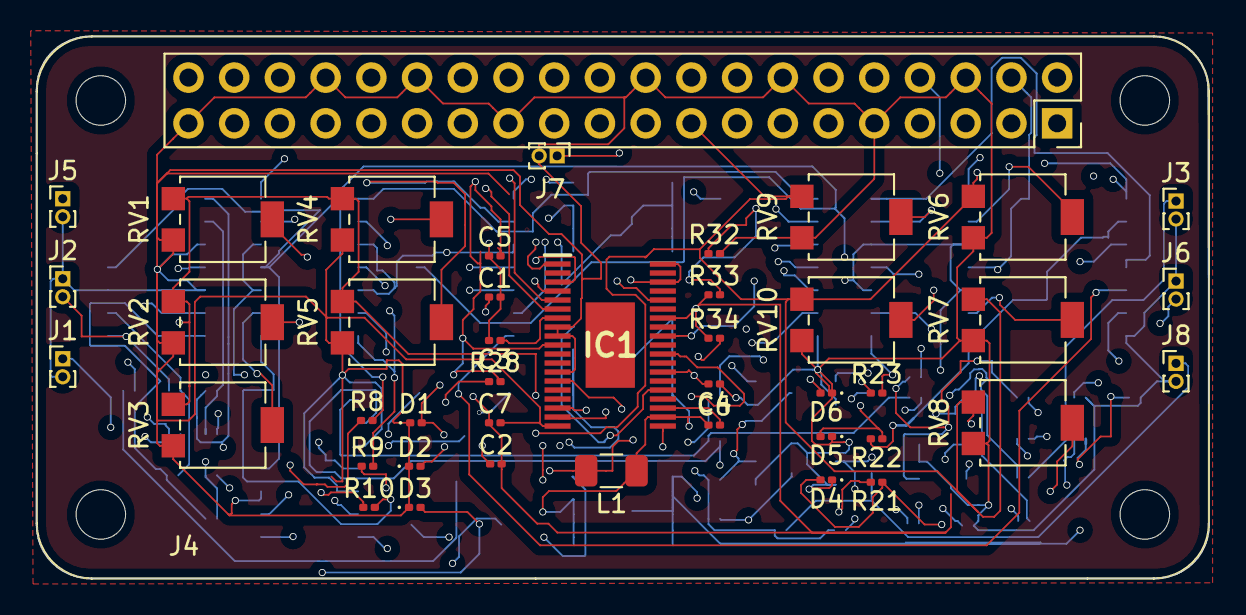
[picture p20: board Main Circuit.kicad_pcb from above]

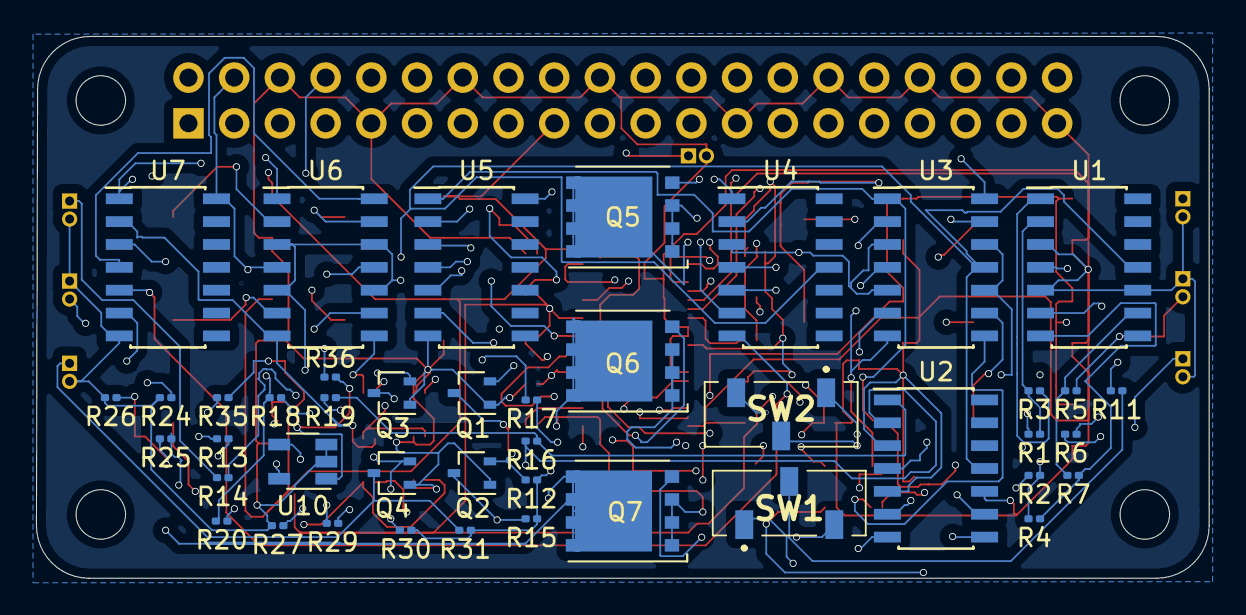
[picture p21: board Main Circuit.kicad_pcb from below]

Board: 6 copper layers, 65.2 x 30.1 mm, 86 parts (43 on the bottom side), 74 nets.
