Cameron-Ray/IrrigationPiHat/Individual Module Schematics/AmplifierSubmodule/Amplifier Submodule.sch

## KiCad design Individual Module Schematics/AmplifierSubmodule/Amplifier Submodule.sch (2021-05-28)

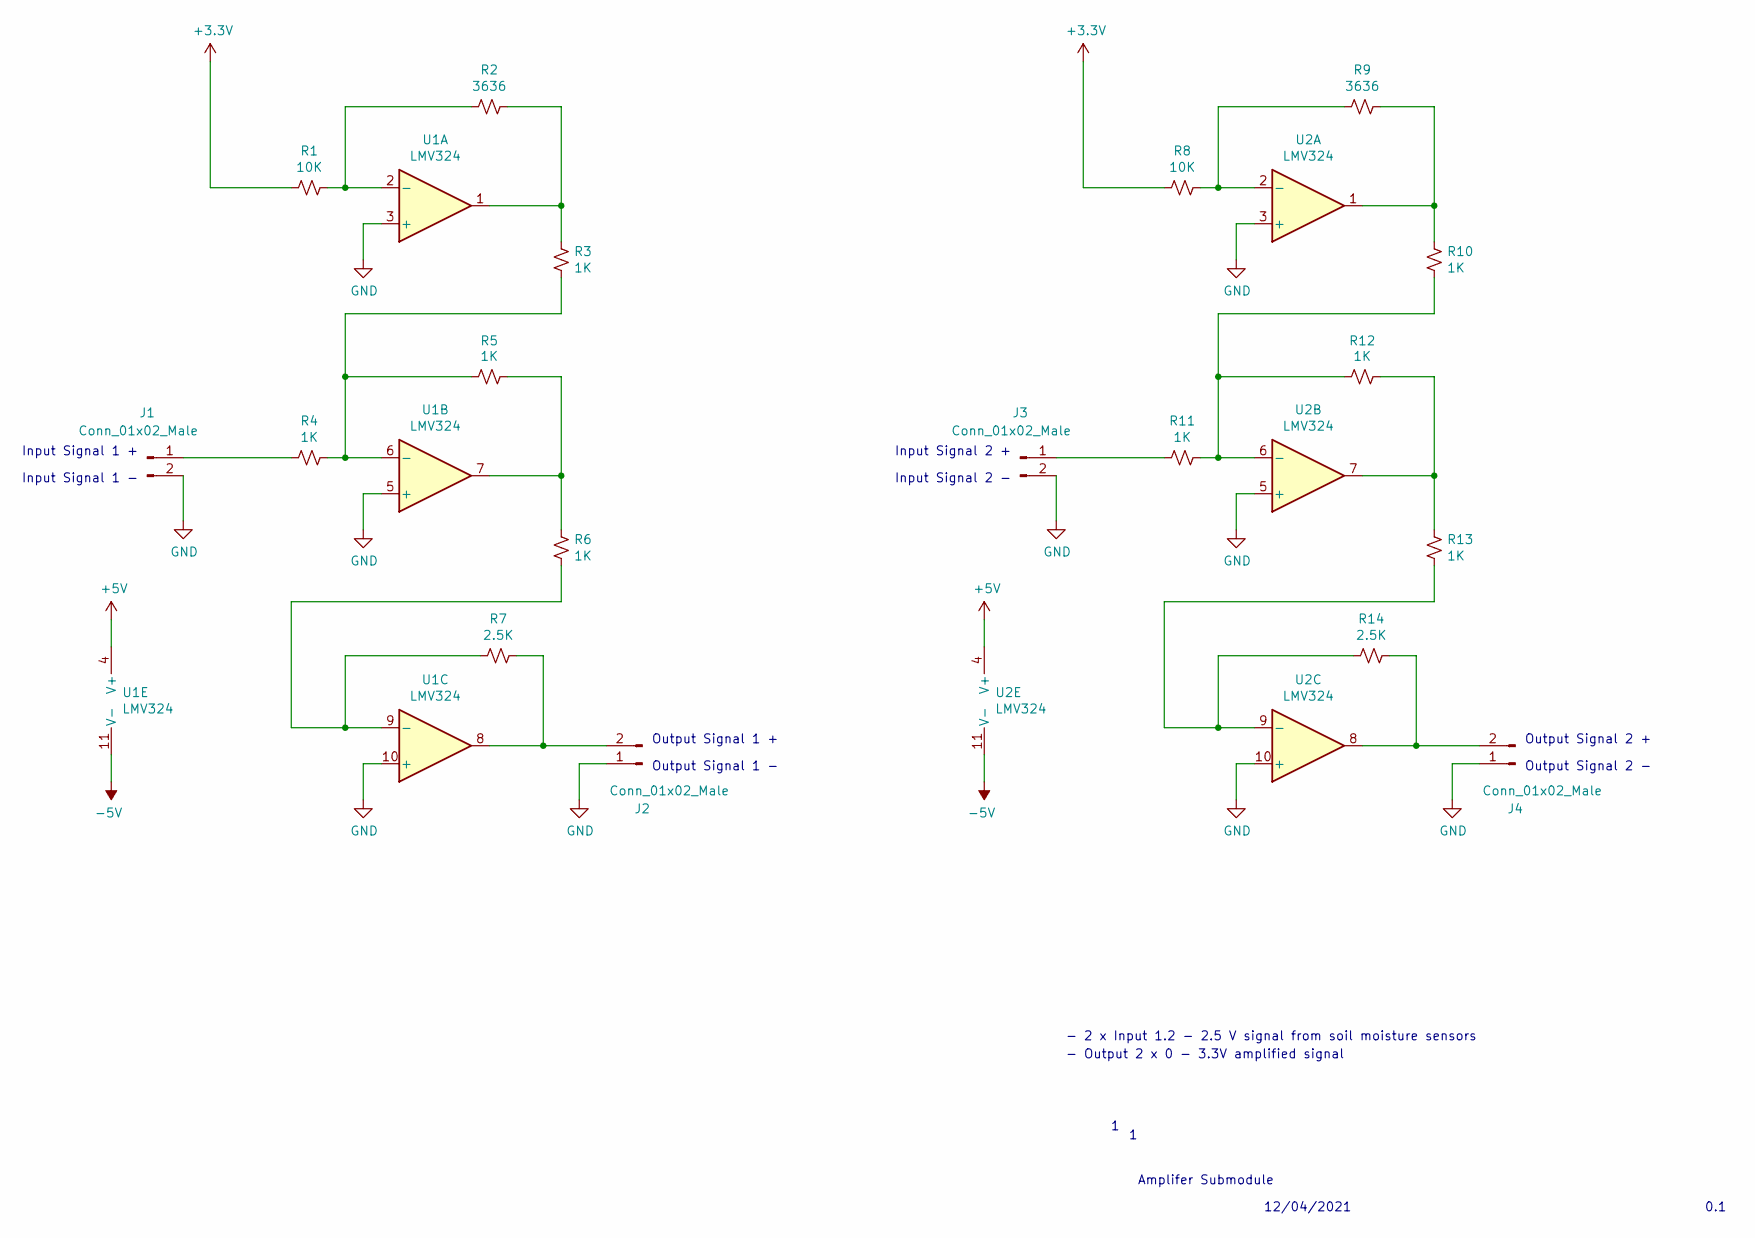
[picture p22: schematic Amplifier Submodule.sch]

Parts:
J1, J2, J3, J4: Conn_01x02_Male
R1, R8: 10K
R2, R9: 3636
R3, R4, R5, R6, R10, R11, R12, R13: 1K
R7, R14: 2.5K
U1, U2: LMV324

Connections:
+3.3V: R1.2, R8.2
+5V: U1.4 (V+), U2.4 (V+)
-5V: U1.11 (V-), U2.11 (V-)
GND: J1.2, J2.1, J3.2, J4.1, U1.3 (+), U1.5 (+), U1.10 (+), U2.3 (+), U2.5 (+), U2.10 (+)
unnamed: J1.1, R4.2
unnamed: J2.2, R7.1, U1.8
unnamed: J3.1, R11.2
unnamed: J4.2, R14.1, U2.8
unnamed: R1.1, R2.2, U1.2 (-)
unnamed: R2.1, R3.1, U1.1
unnamed: R3.2, R4.1, R5.2, U1.6 (-)
unnamed: R5.1, R6.1, U1.7
unnamed: R6.2, R7.2, U1.9 (-)
unnamed: R8.1, R9.2, U2.2 (-)
unnamed: R9.1, R10.1, U2.1
unnamed: R10.2, R11.1, R12.2, U2.6 (-)
unnamed: R12.1, R13.1, U2.7
unnamed: R13.2, R14.2, U2.9 (-)

Notes on the sheet:
Amplifer Submodule
- 2 x Input 1.2 - 2.5 V signal from soil moisture sensors
0.1
12/04/2021
- Output 2 x 0 - 3.3V amplified signal
Input Signal 1 +
Input Signal 1 -
Output Signal 1 +
Output Signal 1 -
Input Signal 2 +
Input Signal 2 -
Output Signal 2 +
Output Signal 2 -
