Cameron-Ray/IrrigationPiHat/Individual Module Schematics/LedSubmodule/LED Submodule.sch

## KiCad design Individual Module Schematics/LedSubmodule/LED Submodule.sch (2021-06-04)

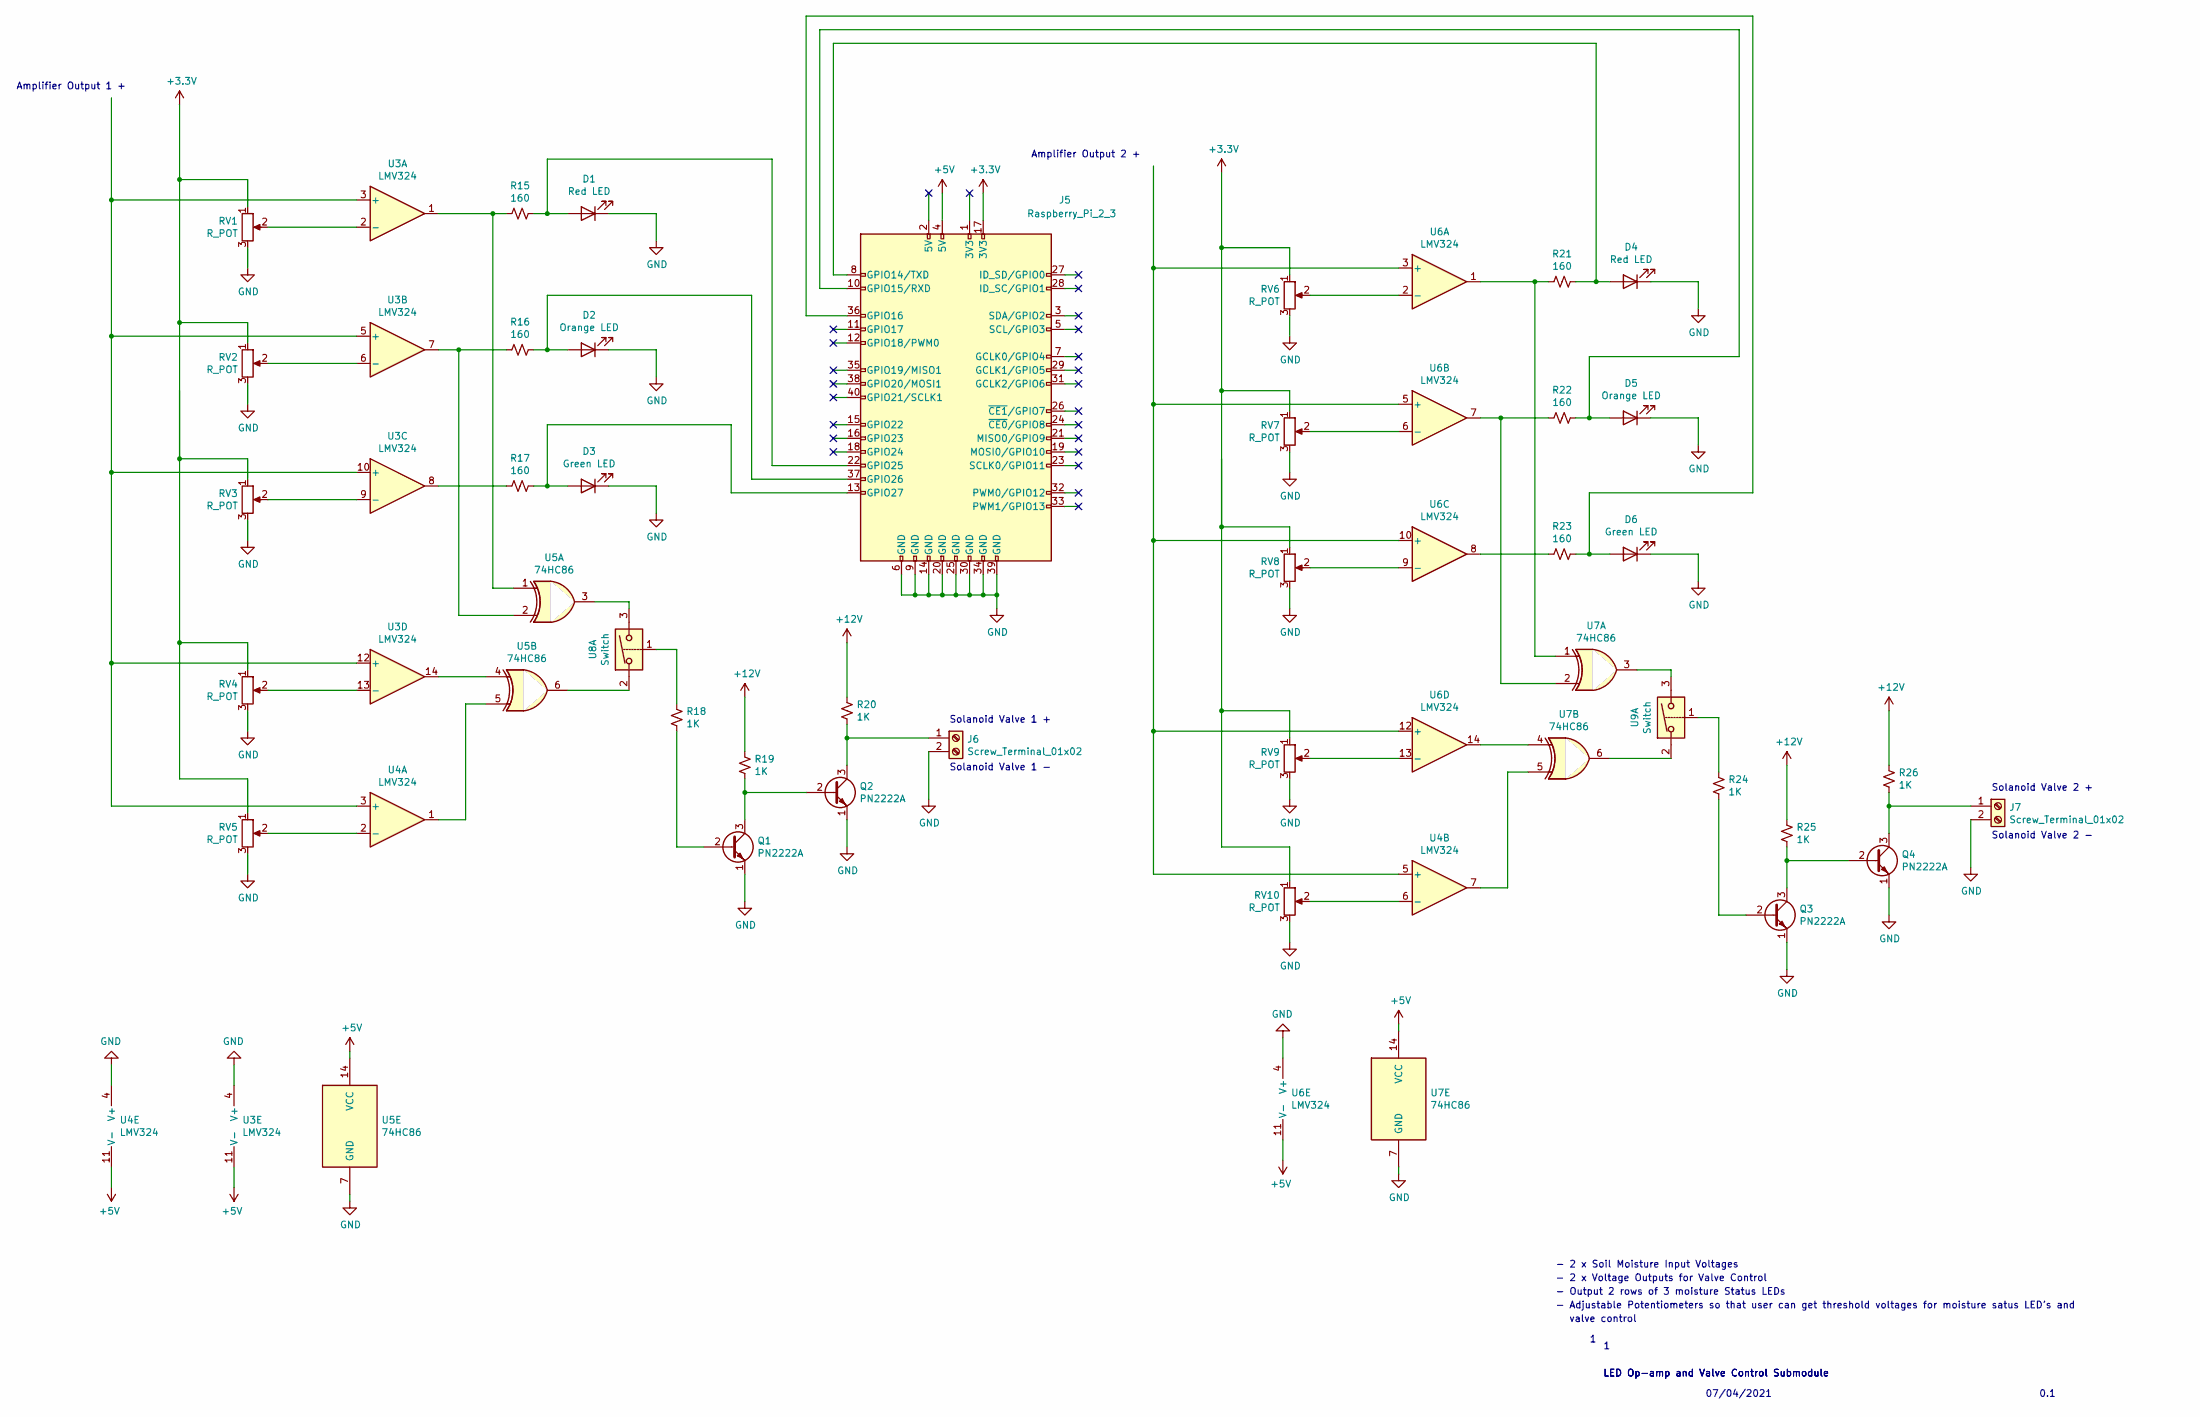
[picture p23: schematic LED Submodule.sch]

Parts:
D1, D4: Red LED
D2, D5: Orange LED
D3, D6: Green LED
J5: Raspberry_Pi_2_3
J6, J7: Screw_Terminal_01x02
Q1, Q2, Q3, Q4: PN2222A; TO-92_Inline
R15, R16, R17, R21, R22, R23: 160
R18, R19, R20, R24, R25, R26: 1K
RV1, RV2, RV3, RV4, RV5, RV6, RV7, RV8, RV9, RV10: R_POT
U3, U4, U6: LMV324
U5, U7: 74HC86
U8, U9: Switch; SOIC-16_3.9x9.9mm_P1.27mm

Connections:
+3.3V: J5.17 (3V3), RV1.1, RV2.1, RV3.1, RV4.1, RV5.1, RV6.1, RV7.1, RV8.1, RV9.1, RV10.1
+5V: J5.4 (5V), U3.11 (V-), U4.11 (V-), U5.14 (VCC), U6.11 (V-), U7.14 (VCC)
+12V: R19.1, R20.1, R25.1, R26.1
GND: D1.1 (K), D2.1 (K), D3.1 (K), D4.1 (K), D5.1 (K), D6.1 (K), J5.6 (GND), J5.9 (GND), J5.14 (GND), J5.20 (GND), J5.25 (GND), J5.30 (GND), J5.34 (GND), J5.39 (GND), J6.2, J7.2, Q1.1 (E), Q2.1 (E), Q3.1 (E), Q4.1 (E), RV1.3, RV2.3, RV3.3, RV4.3, RV5.3, RV6.3, RV7.3, RV8.3, RV9.3, RV10.3, U3.4 (V+), U4.4 (V+), U5.7 (GND), U6.4 (V+), U7.7 (GND)
unnamed: D1.2 (A), J5.22 (GPIO25), R15.1
unnamed: D2.2 (A), J5.37 (GPIO26), R16.1
unnamed: D3.2 (A), J5.13 (GPIO27), R17.1
unnamed: D4.2 (A), J5.8 (GPIO14/TXD), R21.1
unnamed: D5.2 (A), J5.10 (GPIO15/RXD), R22.1
unnamed: D6.2 (A), J5.36 (GPIO16), R23.1
unnamed: J6.1, Q2.3 (C), R20.2
unnamed: J7.1, Q4.3 (C), R26.2
unnamed: Q1.2 (B), R18.2
unnamed: Q1.3 (C), Q2.2 (B), R19.2
unnamed: Q3.2 (B), R24.2
unnamed: Q3.3 (C), Q4.2 (B), R25.2
unnamed: R15.2, U3.1, U5.1
unnamed: R16.2, U3.7, U5.2
unnamed: R17.2, U3.8
unnamed: R18.1, U8.1
unnamed: R21.2, U6.1, U7.1
unnamed: R22.2, U6.7, U7.2
unnamed: R23.2, U6.8
unnamed: R24.1, U9.1
unnamed: RV1.2, U3.2 (-)
unnamed: RV2.2, U3.6 (-)
unnamed: RV3.2, U3.9 (-)
unnamed: RV4.2, U3.13 (-)
unnamed: RV5.2, U4.2 (-)
unnamed: RV6.2, U6.2 (-)
unnamed: RV7.2, U6.6 (-)
unnamed: RV8.2, U6.9 (-)
unnamed: RV9.2, U6.13 (-)
unnamed: RV10.2, U4.6 (-)
unnamed: U3.3 (+), U3.5 (+), U3.10 (+), U3.12 (+), U4.3 (+)
unnamed: U3.14, U5.4
unnamed: U4.1, U5.5
unnamed: U4.5 (+), U6.3 (+), U6.5 (+), U6.10 (+), U6.12 (+)
unnamed: U4.7, U7.5
unnamed: U5.3, U8.3
unnamed: U5.6, U8.2
unnamed: U6.14, U7.4
unnamed: U7.3, U9.3
unnamed: U7.6, U9.2

Notes on the sheet:
LED Op-amp and Valve Control Submodule
07/04/2021
0.1
- 2 x Soil Moisture Input Voltages
- Output 2 rows of 3 moisture Status LEDs
- 2 x Voltage Outputs for Valve Control
- Adjustable Potentiometers so that user can get threshold voltages for moisture satus LED’s and
valve control
Amplifier Output 1 +
Solanoid Valve 1 +
Solanoid Valve 1 -
Amplifier Output 2 +
Solanoid Valve 2 +
Solanoid Valve 2 -
