Cameron-Ray/IrrigationPiHat/Individual Module Schematics/PowerSubmodule/Power Module.sch

## KiCad design Individual Module Schematics/PowerSubmodule/Power Module.sch (2021-06-03)

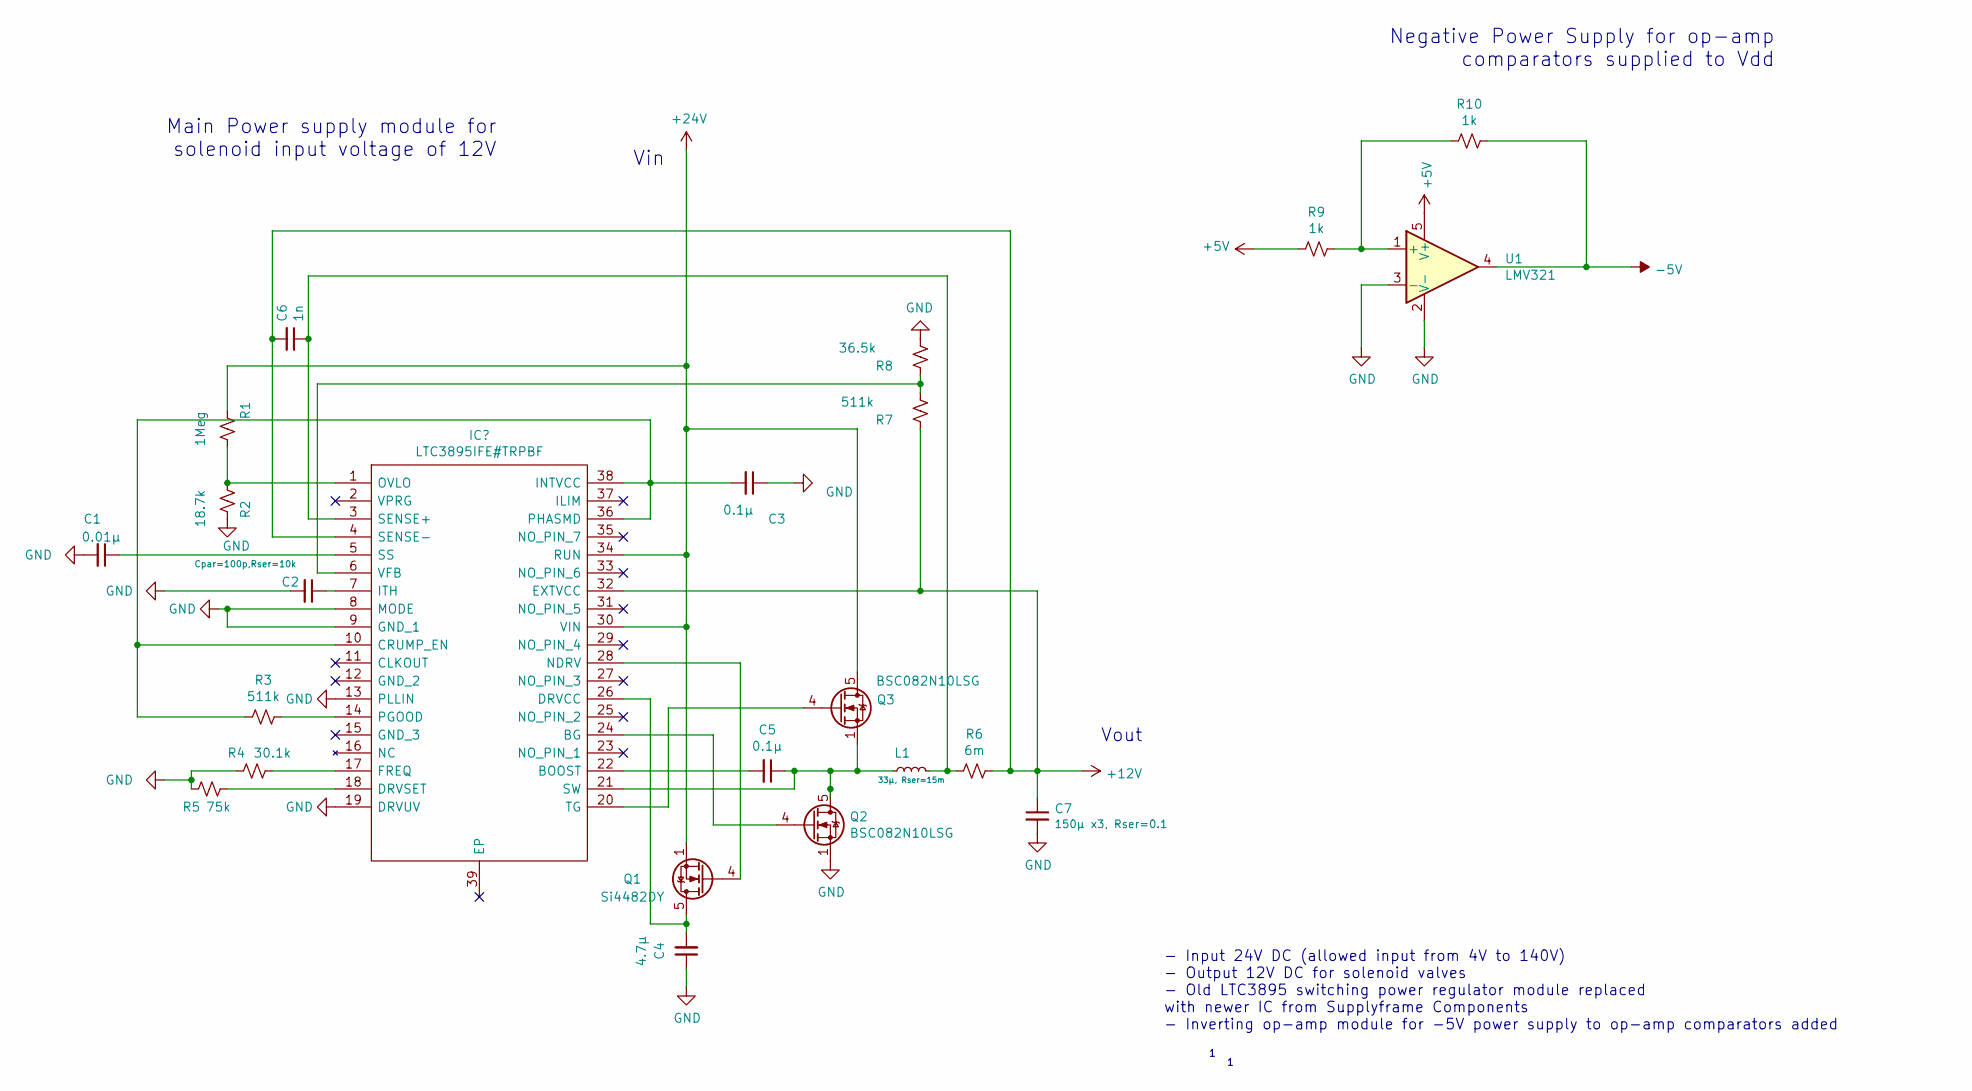
[picture p24: schematic Power Module.sch]

Parts:
C1: 0.01µ
C2: Cpar=100p,Rser=10k
C3, C5: 0.1µ
C4: 4.7µ
C6: 1n
C7: 150µ x3, Rser=0.1
L1: 33µ, Rser=15m
Q1: Si4482DY; TDSON-8-1
Q2, Q3: BSC082N10LSG; TDSON-8-1
R1: 1Meg
R2: 18.7k
R3, R7: 511k
R4: 30.1k
R5: 75k
R6: 6m
R8: 36.5k
R9, R10: 1k
U1: LMV321

Connections:
+5V: R9.2, U1.5 (V+)
+12V: C6.2, C7.1, R6.1, R7.1
+24V: Q1.1 (S), Q1.2 (S), Q1.3 (S), Q3.5 (D), R1.1
-5V: R10.1, U1.4
GND: C1.2, C2.2, C3.1, C4.1, C7.2, Q2.1 (S), Q2.2 (S), Q2.3 (S), R2.2, R4.2, R5.2, R8.2, U1.2 (V-), U1.3 (-)
unnamed: C3.2, R3.2
unnamed: C4.2, Q1.5 (D)
unnamed: C5.1, L1.1, Q2.5 (D), Q3.1 (S), Q3.2 (S), Q3.3 (S)
unnamed: C6.1, L1.2, R6.2
unnamed: R1.2, R2.1
unnamed: R7.2, R8.1
unnamed: R9.1, R10.2, U1.1 (+)

Notes on the sheet:
Vout
Vin
- Input 24V DC (allowed input from 4V to 140V) - Output 12V DC for solenoid valves - Old LTC3895 switching power regulator module replaced with newer IC from Supplyframe Components - Inverting op-amp module for -5V power supply to op-amp comparators added
Negative Power Supply for op-amp comparators supplied to Vdd
Main Power supply module for solenoid input voltage of 12V
