Cameron-Ray/IrrigationPiHat/(commit log)

2021-05-07 Sharepoint sync with git repo, no other changes made to resources
    [Amplifier Submodule.kicad_pcb, Amplifier Submodule.sch, Power Module.kicad_pcb, Power Module.sch, Power Submodule.kicad_pcb, Power Submodule.sch, piHAT .kicad_pcb, piHAT .sch]
2021-05-08 Changed folder nam
    [Amplifier Submodule.kicad_pcb, Amplifier Submodule.sch, Power Module.kicad_pcb, Power Module.sch, Power Submodule.kicad_pcb, Power Submodule.sch, piHAT .kicad_pcb, piHAT .sch]
2021-05-08 Updated directory naming conventions. Added Q1 simulation plots to the report doc. Copied LED & Amplifier subsystem circuit design files across to V1.0 as they are final from V0.1
    [Amplifier Submodule.kicad_pcb, Amplifier Submodule.sch, Power Module.kicad_pcb, Power Module.sch, Power Submodule.kicad_pcb, Power Submodule.sch, piHAT .kicad_pcb, piHAT .sch]
2021-05-21 Assignment 2 final submission and Power Submodule simulation files added
2021-05-28 V2 Power submodule corrected with actual IC from manufacturer's site. Added inverting -5V power supply for op-amp comparator Vdd rail. Created V2 folders and prepped final PCB folder for file creation
    [Amplifier Submodule.kicad_pcb, Amplifier Submodule.sch, Power Module.csv, Power Module.kicad_pcb, Power Module.sch, piHAT .kicad_pcb, piHAT .sch, piHAT-PCB.kicad_pcb]
2021-06-03 Updated File structure and implemented gitignore fully for unecessary generated files. Final Schematic and PCB files added.
    [Amplifier Submodule.kicad_pcb, LED Submodule.sch, LTC3895IFE#TRPBF.stl, LTC3895IFE#TRPBF.stp, Main Circuit.kicad_pcb, Main Circuit.sch, Power Module.csv, Power Module.kicad_pcb]
2021-06-03 Removing files that do not need to be tracked for final repo
    [LED Submodule.sch, Power Submodule.sch, piHAT .kicad_pcb]
2021-06-04 Updated Assignment 3 pdf with details about schematics. Cleaned up schematic files
    [LED Submodule.sch, Main Circuit.kicad_pcb]
2021-06-09 Contributing file added using open-source version. BOM added for overall circuit. Circuit simulation images added for final report as they need to be linked in reference docs (report).
2021-06-09 File structure cleaned again. Created final individual module schematic PDFs
    [Amplifier Submodule.sch, LED Submodule.sch, Power Module.sch, Power Submodule.sch]
2021-06-09 Updated final schematic as incorrect switch packages were selected. Added external switch library
    [JS102011JCQN.stl, JS102011JCQN.stp, Main Circuit.kicad_pcb, Main Circuit.sch]
2021-06-13 Complete Assignment 4 and PCB 3d images added
2021-06-13 Updated Power module How To
2021-06-13 Updated Power Module How To with better formatting
2021-06-18 Updated File structure for more ease of use to end users. Major structure updates made for fresh feel and minimal assigment submission clutter
    [Amplifier Submodule.sch, JS102011JCQN.stl, JS102011JCQN.stp, LED Submodule.sch, LTC3895IFE#TRPBF.stl, LTC3895IFE#TRPBF.stp, Main Circuit.kicad_pcb, Main Circuit.sch]
